Jetsama/DigitalLogicProject/README.md

The Digital Logic Tool is used to help students visualize and use digital logic gates. Each logic gate becomes a physical object for the student to interconnect an experiement with.
