Jetsama/DigitalLogicProject/DOCS/HonorsPoster.odp

Association or meeting title

Date

Department of Electrical and Computer Engineering

Jonathan Hess

Digital Logic Lab Tool

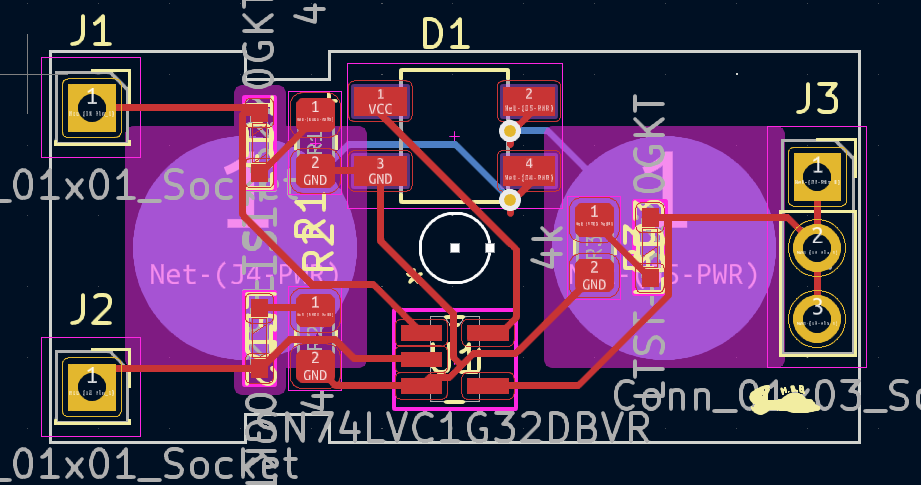
[picture p1: figure]

Content

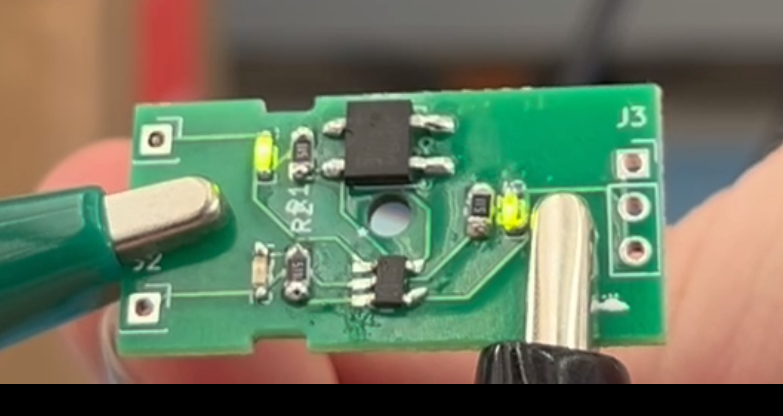
[picture p2: figure]
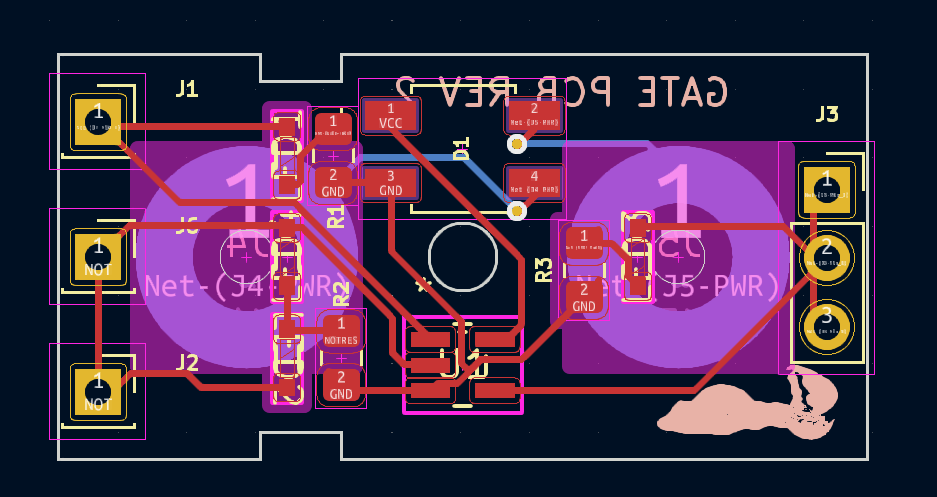
[picture p3: figure]

Acknowledgments
