Jetsama/DigitalLogicProject/PCBS/NOT/documents/pcb.pdf

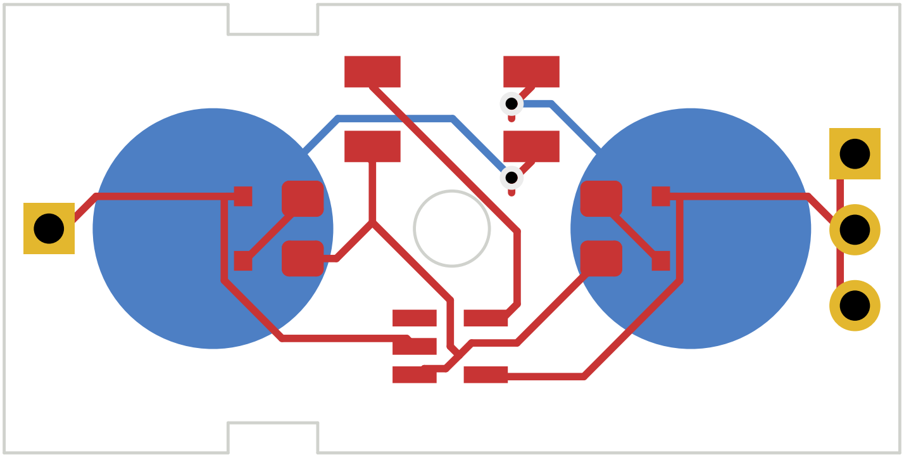
[picture p4: figure]
