Jetsama/DigitalLogicProject/Diagrams/MultiPCBBoardDesign.drawio.png

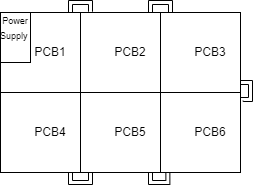
Diagrams/MultiPCBBoardDesign.drawio.png
