Jetsama/DigitalLogicProject/DOCS/images/REV1GATECase.png

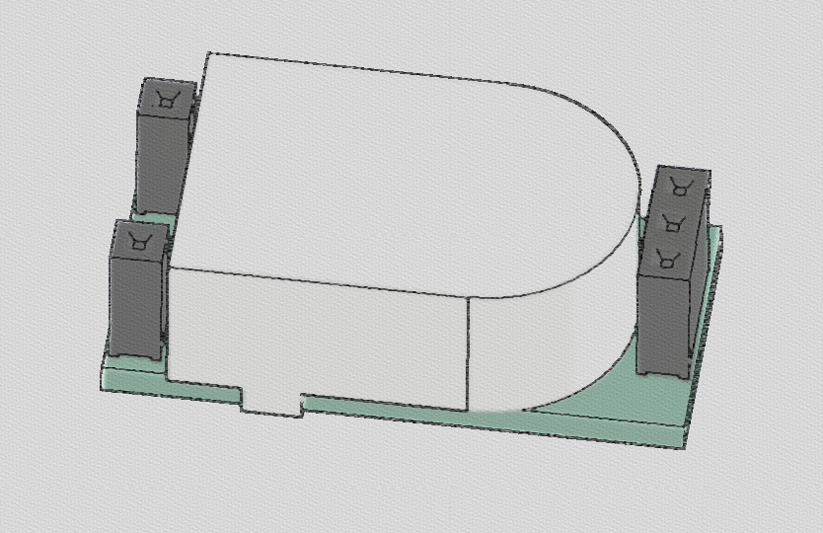
DOCS/images/REV1GATECase.png
