Jetsama/DigitalLogicProject/Models/ANDGATE/AndGate.bmp

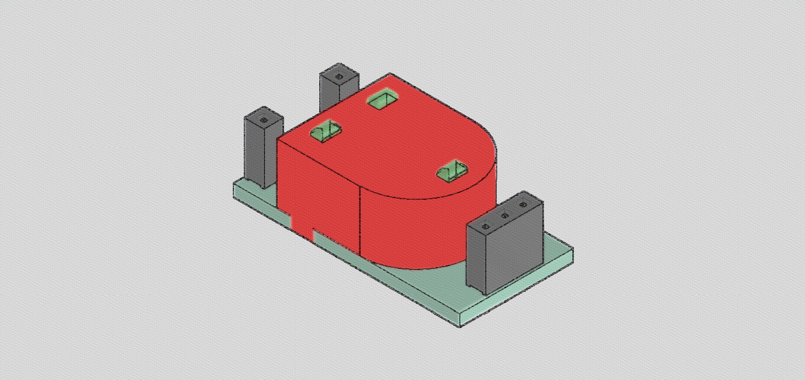
Models/ANDGATE/AndGate.bmp
