Jetsama/DigitalLogicProject/Models/MUX/MuxGate.bmp

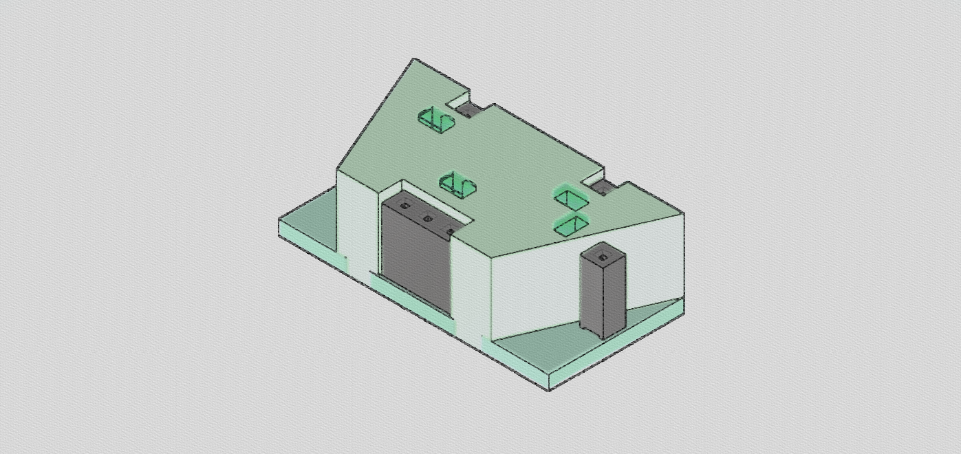
Models/MUX/MuxGate.bmp
