Jetsama/DigitalLogicProject/Models/NOTGATE/not.png

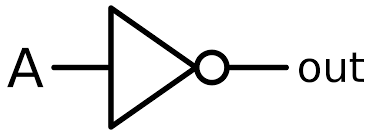
Models/NOTGATE/not.png
