Jetsama/DigitalLogicProject/Models/XORGATE/XorGate.bmp

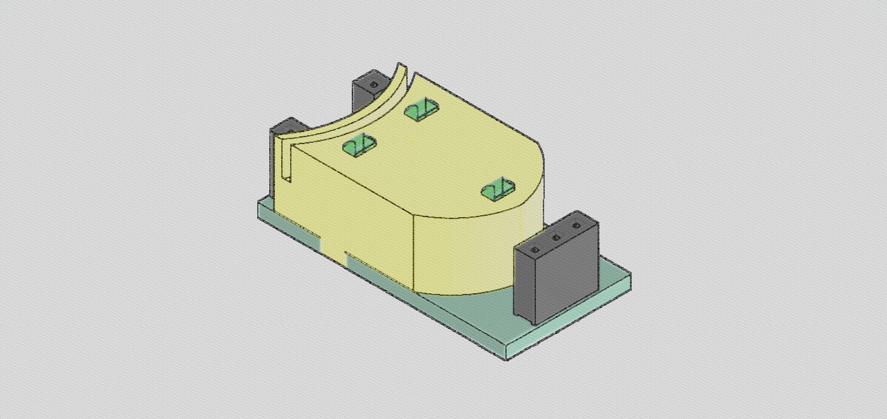
Models/XORGATE/XorGate.bmp
