Jetsama/DigitalLogicProject/DIGITALLOGICFOOTPRINTS/3D model/LTST-S220GKT.stp

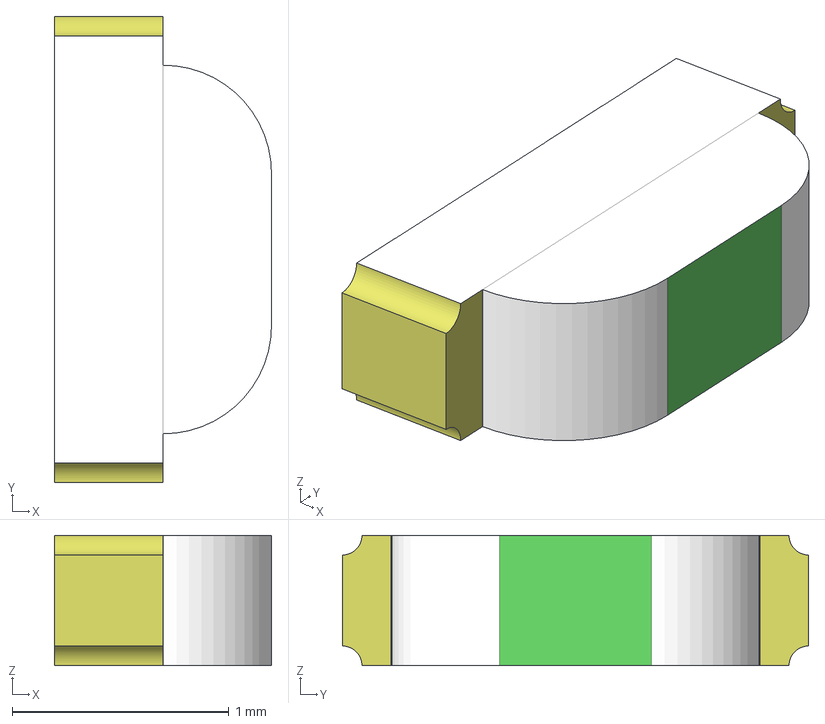
[picture p11: CAD file, 2024-03-07]
DIGITALLOGICFOOTPRINTS/3D model/LTST-S220GKT.stp
1.00 x 2.15 x 0.6 mm
