Jetsama/DigitalLogicProject/Models/ANDGATE/ANDGATE.stl

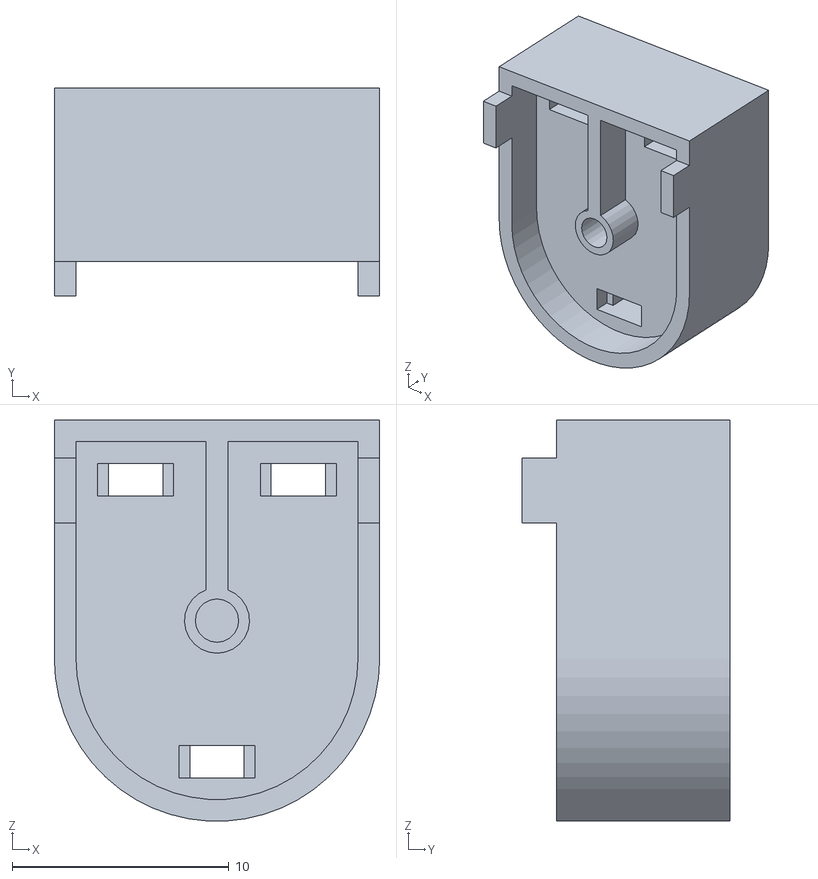
[picture p12: CAD file, 2024-03-28]
Models/ANDGATE/ANDGATE.stl
15.0 x 9.60 x 18.5
