Jetsama/DigitalLogicProject/Models/LIGHTPIPING/LightPipeThin.stl

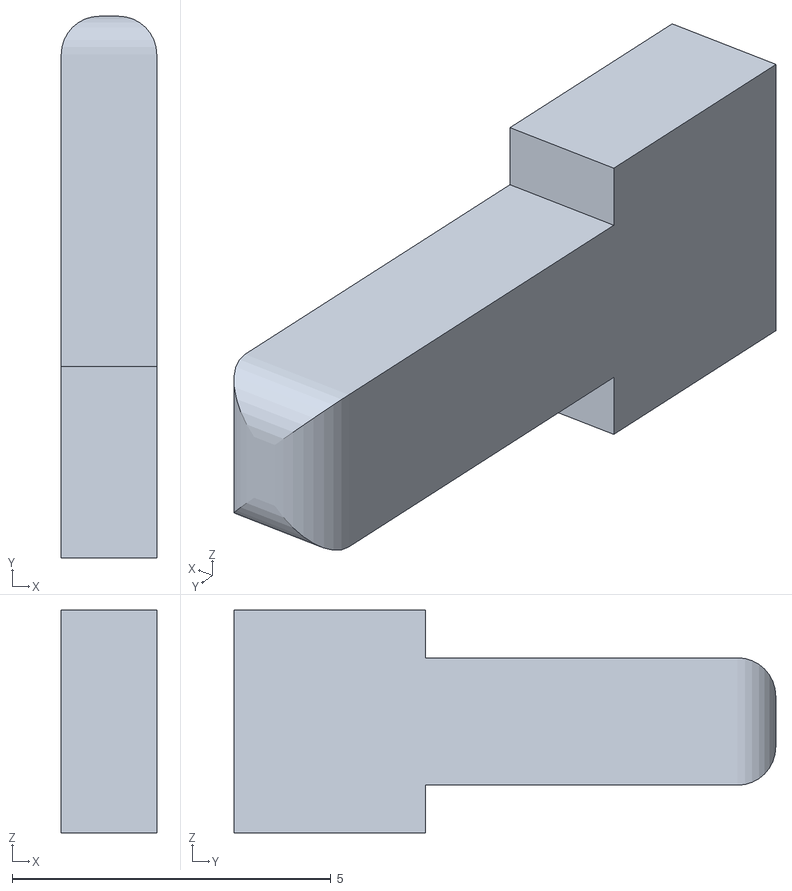
[picture p13: CAD file, 2024-03-28]
Models/LIGHTPIPING/LightPipeThin.stl
1.50 x 8.50 x 3.50
