Jetsama/DigitalLogicProject/Models/MUX/MUX.stl

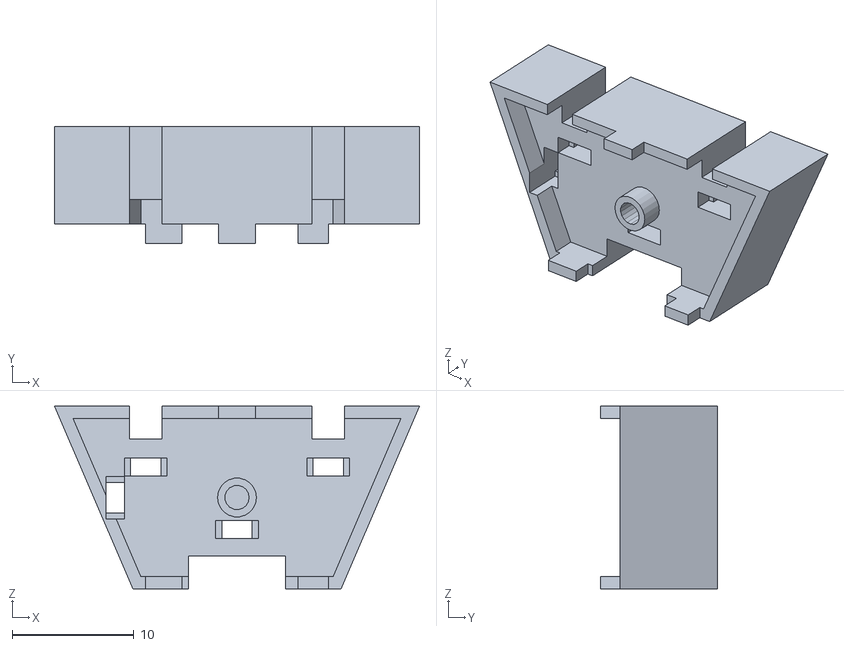
[picture p14: CAD file, 2024-04-11]
Models/MUX/MUX.stl
30.0 x 9.60 x 15.0
