Jetsama/DigitalLogicProject/Models/NANDGATE/NANDGATE.stl

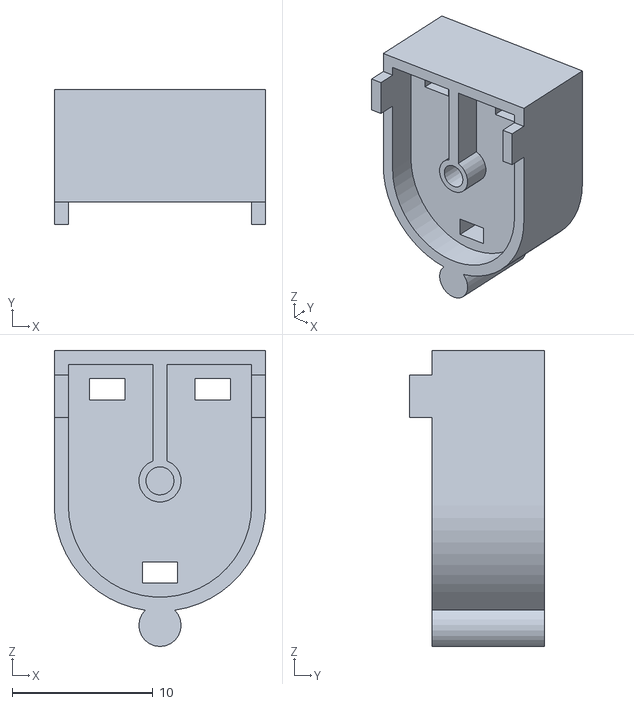
[picture p15: CAD file, 2024-03-28]
Models/NANDGATE/NANDGATE.stl
15.0 x 9.60 x 21.0
