Jetsama/DigitalLogicProject/Models/NORGATE/NORGATE.stl

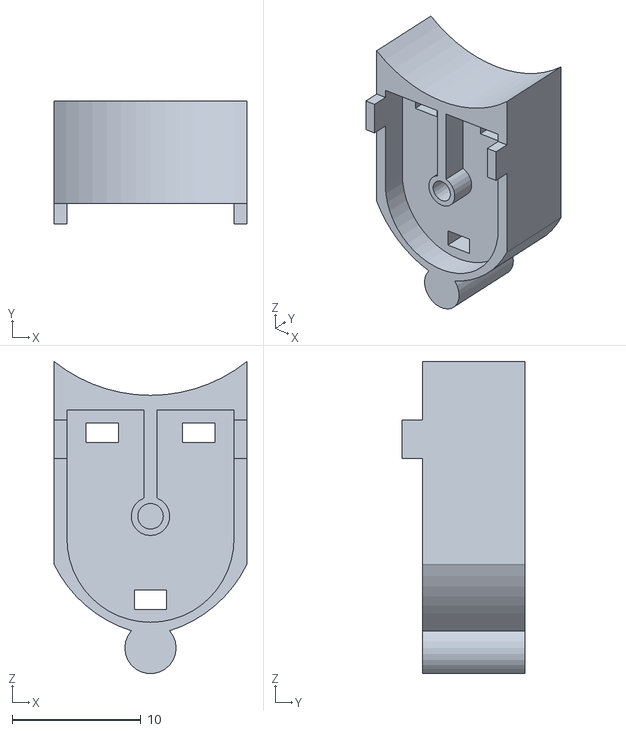
[picture p16: CAD file, 2024-03-28]
Models/NORGATE/NORGATE.stl
15.0 x 9.60 x 24.3
