Jetsama/DigitalLogicProject/Models/NOTGATE/NOTGATE.stl

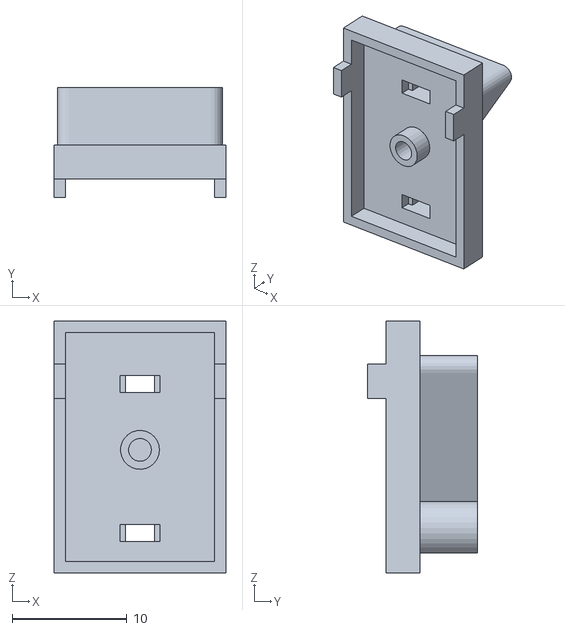
[picture p17: CAD file, 2024-03-28]
Models/NOTGATE/NOTGATE.stl
15.0 x 9.60 x 22.0
