Jetsama/DigitalLogicProject/Models/XORGATE/XORGATE.stl

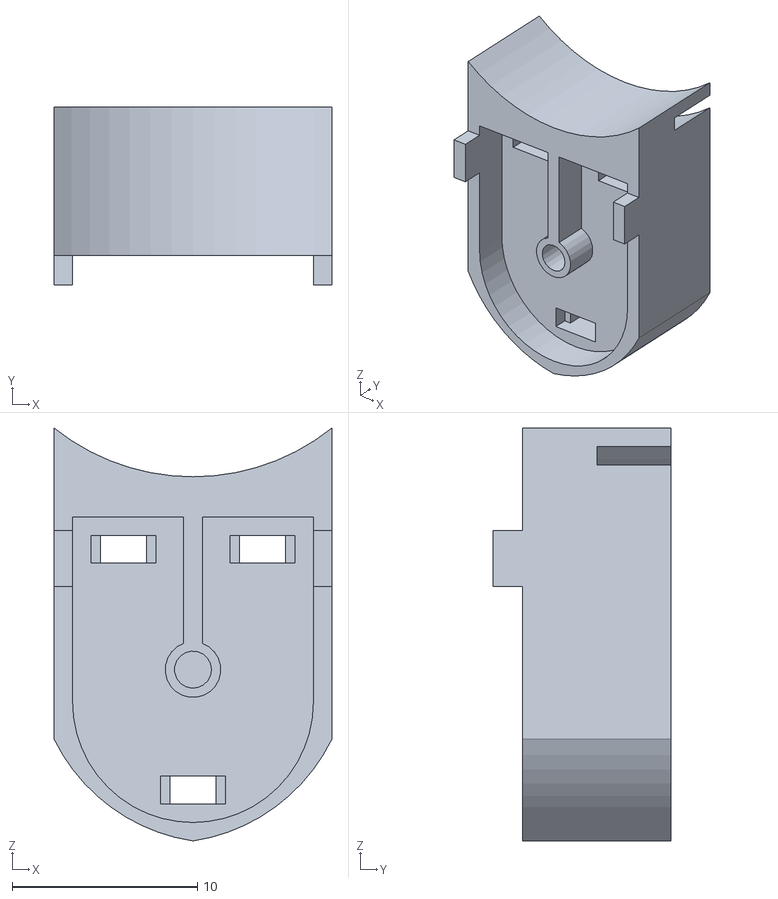
[picture p18: CAD file, 2024-03-28]
Models/XORGATE/XORGATE.stl
15.0 x 9.60 x 22.3
