Jetsama/DigitalLogicProject/PCBS/DISPLAY/DISPLAY.step

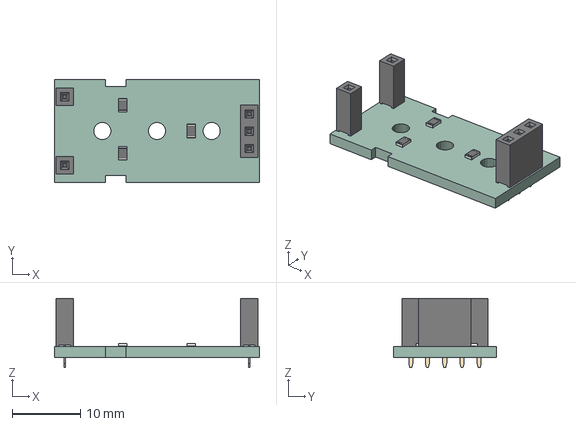
[picture p19: CAD file, 2024-03-07]
PCBS/DISPLAY/DISPLAY.step
30.0 x 15.0 x 10.1 mm
GATE PCB
