Jetsama/DigitalLogicProject/PCBS/MUX/MUX.step

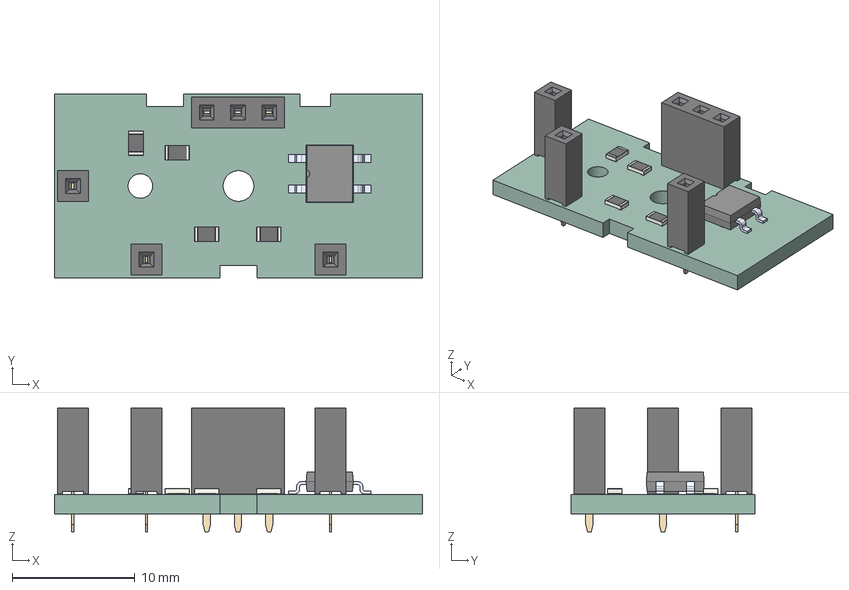
[picture p20: CAD file, 2024-03-15]
PCBS/MUX/MUX.step
30.0 x 15.0 x 10.1 mm
_autosave-MUX PCB
