Jetsama/DigitalLogicProject/PCBS/SWITCHES/SWITCHES.step

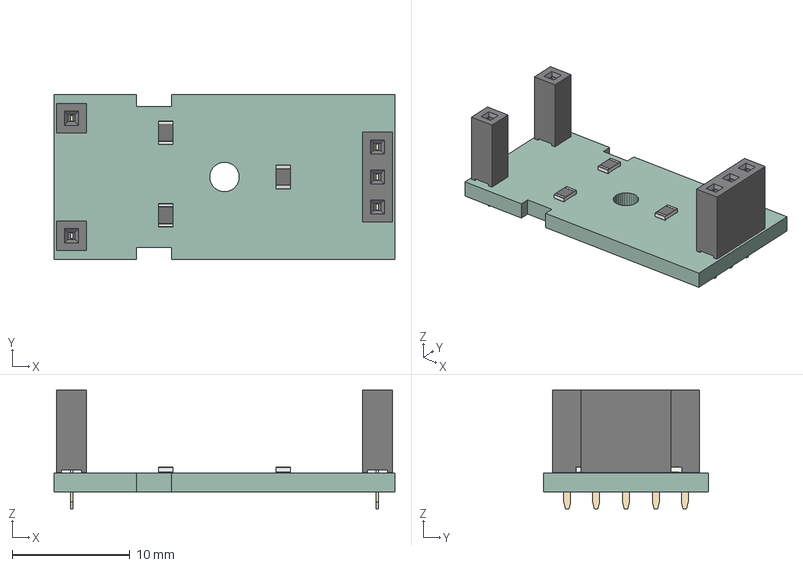
[picture p21: CAD file, 2024-01-23]
PCBS/SWITCHES/SWITCHES.step
29.0 x 14.0 x 10.1 mm
ANDGATE PCB
