Jetsama/DigitalLogicProject/DIGITALLOGICFOOTPRINTS/3D model/IRLZ44NPBF.step

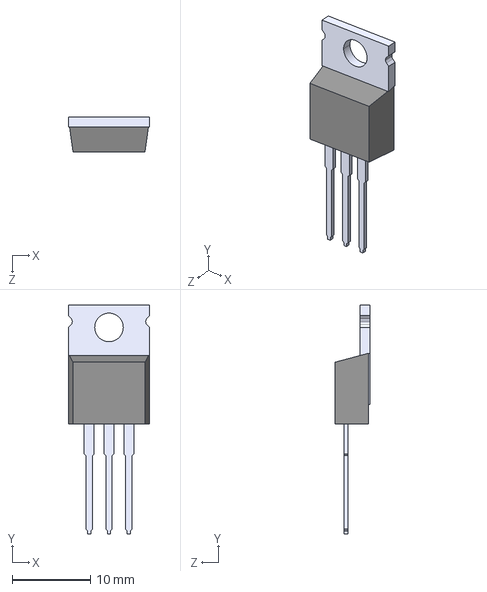
[picture p22: CAD file, 2024-03-07]
DIGITALLOGICFOOTPRINTS/3D model/IRLZ44NPBF.step
10.4 x 29.3 x 4.45 mm
