Jetsama/DigitalLogicProject/Models/LIGHTPIPING/LightPipe.stl

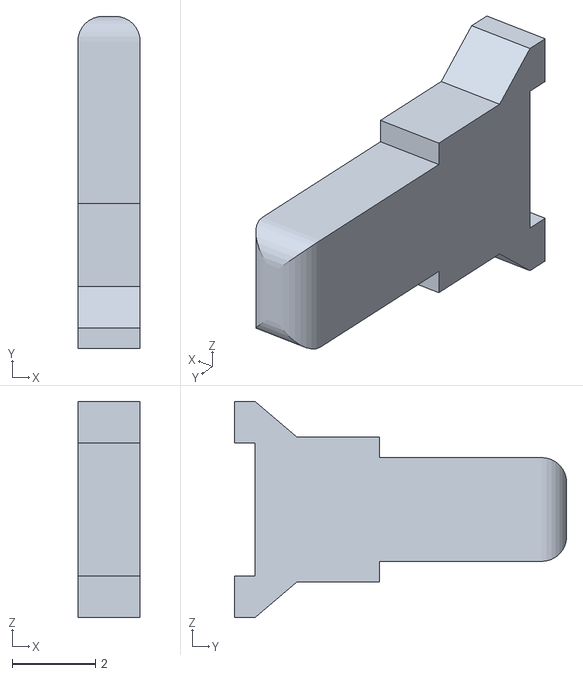
[picture p23: CAD file, 2024-03-28]
Models/LIGHTPIPING/LightPipe.stl
1.50 x 8.00 x 5.20
