Jetsama/DigitalLogicProject/PCBS/DISPLAY/ANDGATE.step

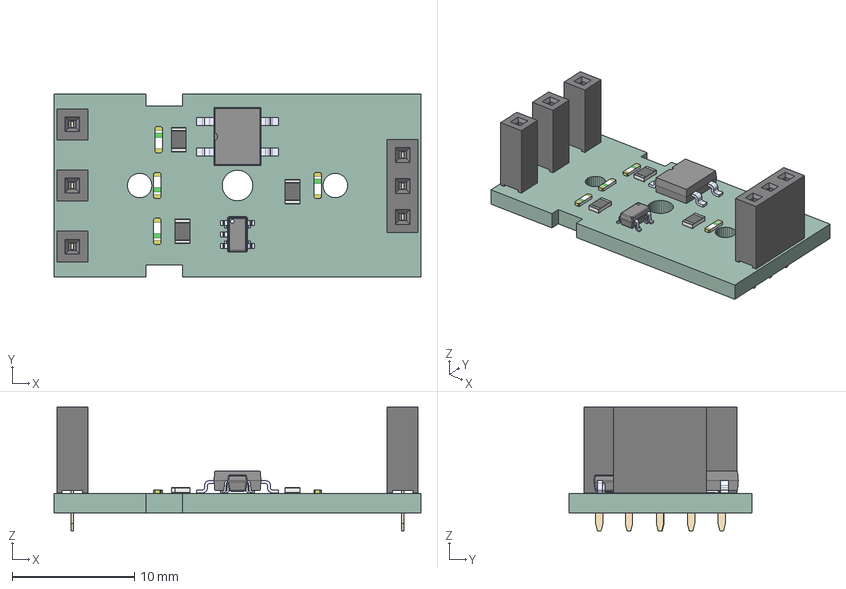
[picture p24: CAD file, 2024-03-07]
PCBS/DISPLAY/ANDGATE.step
30.0 x 15.0 x 10.1 mm
GATE PCB
