Jetsama/DigitalLogicProject/DIGITALLOGICFOOTPRINTS/3D model/MB10F-13.step

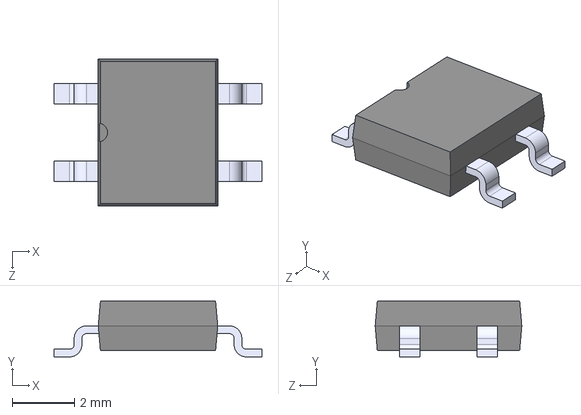
[picture p25: CAD file, 2024-02-16]
DIGITALLOGICFOOTPRINTS/3D model/MB10F-13.step
6.70 x 1.80 x 4.72 mm
