Jetsama/DigitalLogicProject/Models/LIGHTPIPING/LightPipe1mm.stl

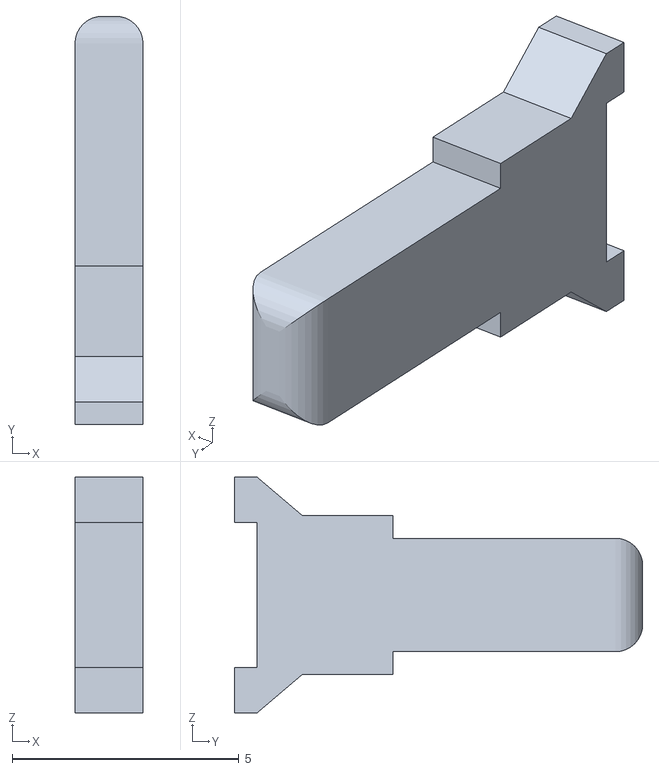
[picture p26: CAD file, 2024-03-28]
Models/LIGHTPIPING/LightPipe1mm.stl
1.50 x 9.00 x 5.20
