Jetsama/DigitalLogicProject/Models/LIGHTPIPING/LightPipeThin1m.stl

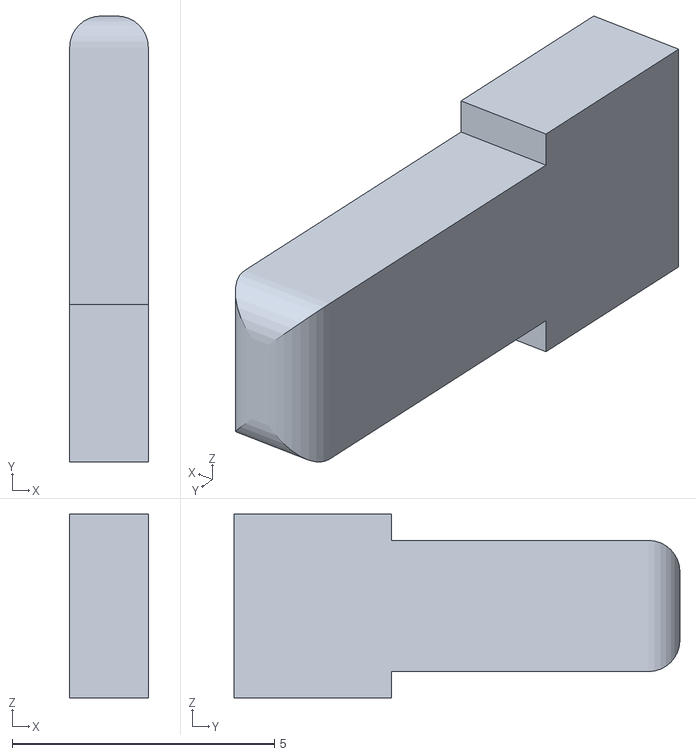
[picture p27: CAD file, 2024-03-28]
Models/LIGHTPIPING/LightPipeThin1m.stl
1.50 x 8.50 x 3.50
