Jetsama/DigitalLogicProject/DIGITALLOGICFOOTPRINTS/3D model/CUI_DEVICES_RDS-16S-1045-D.step

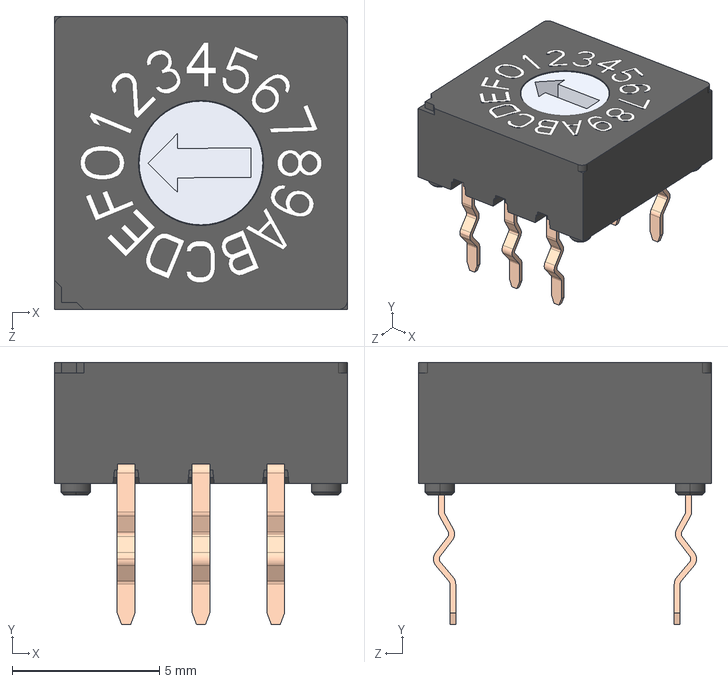
[picture p28: CAD file, 2024-02-16]
DIGITALLOGICFOOTPRINTS/3D model/CUI_DEVICES_RDS-16S-1045-D.step
9.95 x 8.91 x 9.95 mm
