Jetsama/DigitalLogicProject/DIGITALLOGICFOOTPRINTS/3D model/CUI_DEVICES_RDS-16S-1055-SMT.step

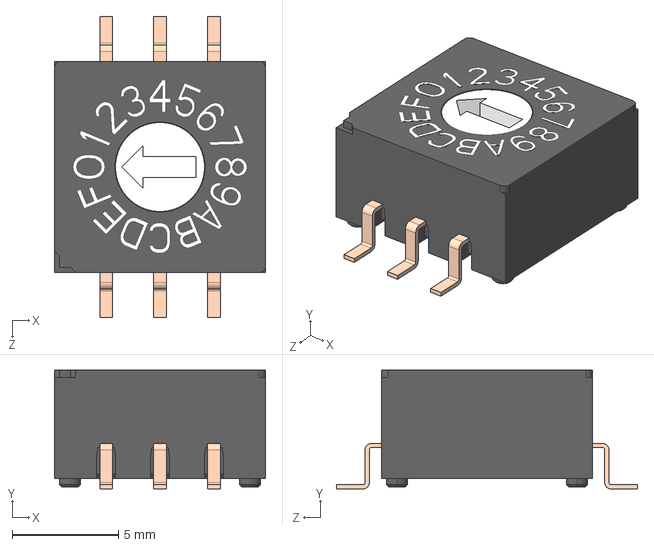
[picture p29: CAD file, 2024-02-16]
DIGITALLOGICFOOTPRINTS/3D model/CUI_DEVICES_RDS-16S-1055-SMT.step
9.95 x 5.61 x 14.2 mm
