Jetsama/DigitalLogicProject/DIGITALLOGICFOOTPRINTS/3D model/SN74LVC1GU04.step

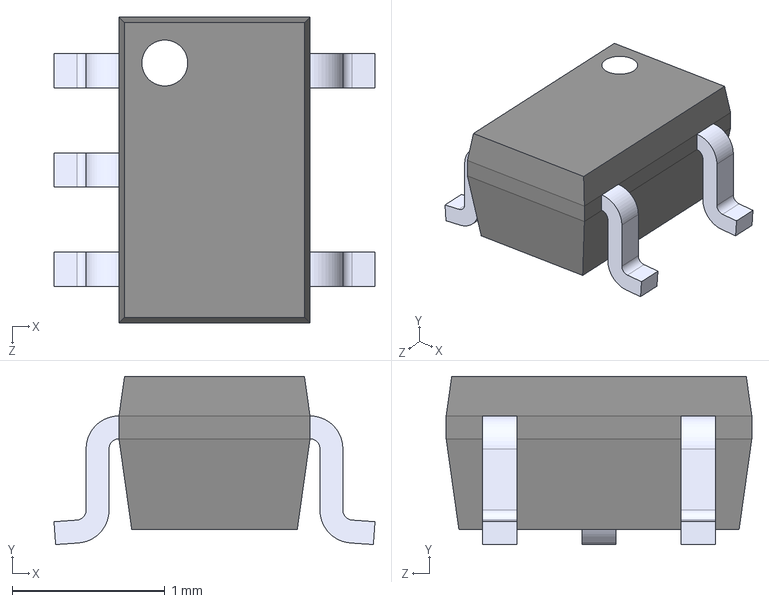
[picture p30: CAD file, 2024-02-16]
DIGITALLOGICFOOTPRINTS/3D model/SN74LVC1GU04.step
2.10 x 1.10 x 2.00 mm
