Jetsama/DigitalLogicProject/DIGITALLOGICFOOTPRINTS/3D model/SN74LVC2G157DCTR.step

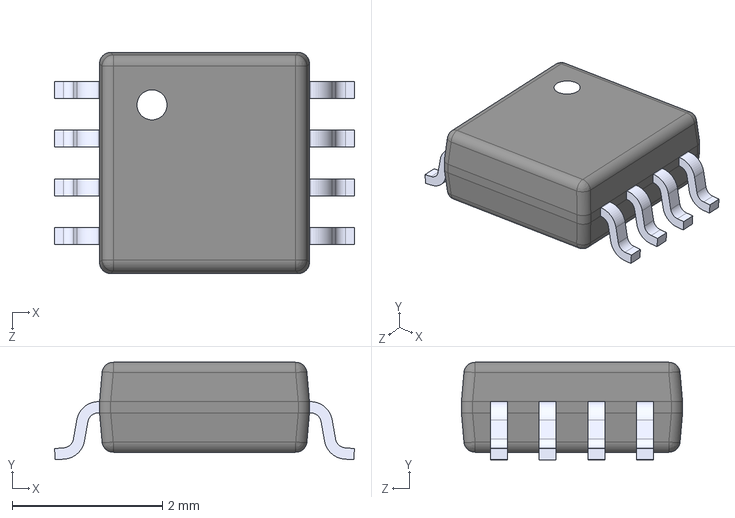
[picture p31: CAD file, 2024-02-16]
DIGITALLOGICFOOTPRINTS/3D model/SN74LVC2G157DCTR.step
4.00 x 1.30 x 2.95 mm
