Jetsama/DigitalLogicProject/DIGITALLOGICFOOTPRINTS/3D model/CD4043BPWR.step

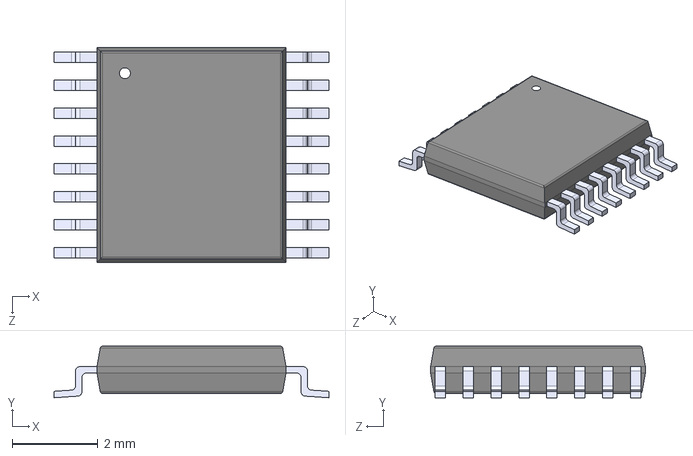
[picture p32: CAD file, 2024-02-16]
DIGITALLOGICFOOTPRINTS/3D model/CD4043BPWR.step
6.40 x 1.20 x 5.00 mm
