Jetsama/DigitalLogicProject/DIGITALLOGICFOOTPRINTS/3D model/SN74LVC1G08DBVRE4.step

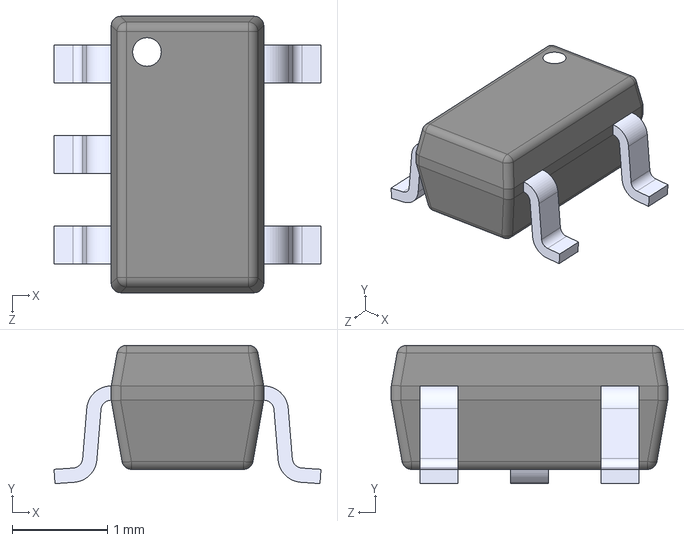
[picture p33: CAD file, 2024-02-16]
DIGITALLOGICFOOTPRINTS/3D model/SN74LVC1G08DBVRE4.step
2.80 x 1.45 x 2.90 mm
