Jetsama/DigitalLogicProject/(list of files, cad)

Other CAD files:
Models/ORGATE/ORGATE.stl
DIGITALLOGICFOOTPRINTS/3D model/1571527-2.step
Gates/NOTGATE/ANDGATE PCB.ipt
Gates/NOTGATE/OldVersions/ANDGATE PCB.0003.ipt
Models/ANDGATE/ANDGATE PCB.ipt
Models/ANDGATE/ANDGATE.iam
Models/ANDGATE/ANDGATE.ipt
Models/ANDGATE/ANDGATEASSEMBLY.iam
Models/ANDGATE/OldVersions/ANDGATE.0015.ipt
Models/ANDGATE/OldVersions/ANDGATEASSEMBLY.0003.iam
Models/LIGHTPIPING/LightPipe.ipt
Models/LIGHTPIPING/LightPipeThin.ipt
Models/LIGHTPIPING/OldVersions/LightPipe.0003.ipt
Models/LIGHTPIPING/OldVersions/LightPipeThin.0001.ipt
Models/MUX/MUX.ipt
Models/MUX/MUXAssembly1.iam
Models/MUX/MUXPCB.ipt
Models/MUX/OldVersions/MUX.0010.ipt
Models/MUX/OldVersions/MUXAssembly1.0001.iam
Models/MUX/OldVersions/MUXPCB.0001.ipt
Models/NANDGATE/NANDGATE.ipt
Models/NANDGATE/NANDGATEASSEMBLY.iam
Models/NANDGATE/OldVersions/NANDGATE.0004.ipt
Models/NANDGATE/OldVersions/NANDGATEASSEMBLY.0003.iam
Models/NORGATE/NORGATE.ipt
Models/NORGATE/NORGATEASSEMBLY.iam
Models/NORGATE/OldVersions/NORGATE.0005.ipt
Models/NORGATE/OldVersions/NORGATEASSEMBLY.0002.iam
Models/NOTGATE/NOTGATE.ipt
Models/NOTGATE/NOTGATE2.ipt
Models/NOTGATE/NOTGATEASSEMBLY.iam
Models/NOTGATE/OldVersions/NOTGATE.0005.ipt
Models/NOTGATE/OldVersions/NOTGATE2.0003.ipt
Models/NOTGATE/OldVersions/NOTGATEASSEMBLY.0001.iam
Models/ORGATE/ORGATE.ipt
Models/ORGATE/ORGATEASSEMBLY.iam
Models/ORGATE/OldVersions/ORGATE.0006.ipt
Models/ORGATE/OldVersions/ORGATEASSEMBLY.0002.iam
Models/XORGATE/OldVersions/XORGATE.0002.ipt
Models/XORGATE/OldVersions/XORGATEASSEMBLY.0002.iam
Models/XORGATE/XORGATE.ipt
Models/XORGATE/XORGATEASSEMBLY.iam
PCBS/DISPLAY/ANDGATEASSEMBLY.iam
PCBS/DISPLAY/DISPLAY.iam
PCBS/DISPLAY/DISPLAY.ipt
PCBS/DISPLAY/GATE PCB.ipt
PCBS/DISPLAY/OldVersions/ANDGATE PCB.0001.ipt
PCBS/DISPLAY/OldVersions/ANDGATE.0008.ipt
PCBS/DISPLAY/OldVersions/GATE PCB.0002.ipt
PCBS/DISPLAY/PinSocket_1x01_P2.54mm_Vertical.iam
PCBS/DISPLAY/PinSocket_1x03_P2.54mm_Vertical.iam
PCBS/DISPLAY/Quarter.ipt
PCBS/DISPLAY/R_0805_2012Metric.iam
PCBS/DISPLAY/SOLID.ipt
PCBS/DISPLAY/SOLID_1.ipt
PCBS/DISPLAY/SOLID_2.ipt
PCBS/GATE/GATE PCB.ipt
PCBS/GATE/OldVersions/GATE PCB.0004.ipt
