Jetsama/DigitalLogicProject/(threads)

Thread 1 (2023-12-20):

Creation of AND gate PCB

Jetsama, 2023-12-20:
Create an AND gate PCB with two 8mm button inputs at the bottom and 3 input 5mm on the top.

Jetsama, 2023-12-29:
Completed with the PCB shown below. Changed to using standard socket pin headers rather than 5mm.

PCB Design:
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

3D Model:
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

Finalization of PCB will add ridges to allow casing to grip onto PCB and also potentially needing to move D1 for screw tolerances.

Closed 2023-12-29.

Thread 2 (2023-12-29):

Creation of AND gate casing

Jetsama, 2023-12-29:
Create 3D model for AND gate PCB with screw hole and holes for header pins.
This case should look similar to how a AND gate looks in diagrams. An example of an old casing model is shown below.
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

Jetsama, 2024-01-23:
Added mounting grooves. Last step is to add holes for light piping the leds.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

Jetsama, 2024-03-14:
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
Added the LED piping

Closed 2024-03-14.

Thread 3 (2023-12-29):

Create paneling for JLCPCB

Jetsama, 2023-12-29:
Create a paneling design to allow for 10 PCB's per board (with 5 maximum different designs).
This information is laid out in the [PCB-Panelization](https://jlcpcb.com/help/article/96-PCB-Panelization) page on JLCPCB.

The current plan for designs are:

1. 2 input, 1 output GATE (AND,OR,NAND, etc)
2. 1 input, 1 output GATE (NOT)
3. inputs PCB (for switches and buttons)
4. Mux GATE
5. 7 segment display PCB

Jetsama, 2024-02-16:
Paneling has 15 dollar fee for designs with size less than 1.5cm by 1.5cm.
This actually should be worded that if any dimension is less than 1.5cm it will be feed. This means that the size of the PCB cannot be 1.4cm by 2.9cm.
https://jlcpcb.com/help/article/55-How-do-I-order-a-panel
We need to increase size of PCB to height of 1.5cm if we want to use panel.

Jetsama, 2024-02-17:
Calculated costs and used panelization by JLCPCB. for
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

Without Engineering Fees (4 dollars): (Col: PCB per panel, Row: Panels)
|     | 15      |     |        | 18      |     |        | 21      |     |        | 24      |     |        | 27      |     |        | 30      |     |        |
| :-- | :------ | :-- | :----- | :------ | :-- | :----- | :------ | :-- | :----- | :------ | :-- | :----- | :------ | :-- | :----- | :------ | :-- | :----- |
| 5   | $3.80  | 75  | $0.05 | $4.30  | 90  | $0.05 | $4.90  | 105 | $0.05 | $5.40  | 120 | $0.05 | $6.00  | 135 | $0.04 | $6.50  | 150 | $0.04 |
| 10  | $6.50  | 150 | $0.04 | $7.60  | 180 | $0.04 | $8.70  | 210 | $0.04 | $9.70  | 240 | $0.04 | $10.80 | 270 | $0.04 | $11.90 | 300 | $0.04 |
| 15  | $9.20  | 225 | $0.04 | $10.80 | 270 | $0.04 | $12.50 | 315 | $0.04 | $14.00 | 360 | $0.04 | $15.70 | 405 | $0.04 | $17.30 | 450 | $0.04 |
| 20  | $11.90 | 300 | $0.04 | $14.00 | 360 | $0.04 | $16.30 | 420 | $0.04 | $18.40 | 480 | $0.04 | $20.50 | 540 | $0.04 | $22.70 | 600 | $0.04 |

The cost of board goes down to 4 cents regardless of number. This means that no reason for mid-mass quantity doesn't yield benefit over 135 boards from JLCPCB.

Closed 2024-02-17.

Thread 4 (2023-12-29):

Creation of NOT gate PCB

Jetsama, 2023-12-29:
Create a NOT gate PCB with two 8mm button inputs at the bottom following grid design. Also includes the input 1 pin header and output 3 pin socket header.

Jetsama, 2024-01-29:
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
Finished NOT gate PCB

Closed 2024-01-29.

Thread 5 (2024-01-17):

Creation of MUX gate PCB

Jetsama, 2024-01-17:
Create a MUX gate PCB with two 8mm button inputs at the bottom following grid design. Also includes the 3 input pin headers one on top and 2 pin headers on side. Then we have theoutput 3 pin socket header.

Should be laid out like so:
```c

      1
   _______
1 |       \
  |        \
  |         | 3
  |        /
1 |_______/
```

Jetsama, 2024-02-12:
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

Created Mux PCB with 3 inputs and 1 output.
Cleanup of Silkscreen still preferred before production.
BOM and JLCPCB output needed.

Closed 2024-02-12.

Thread 6 (2024-01-24):

Creation of NOT gate casing

Jetsama, 2024-01-24:
Create 3D model for NOT gate PCB with screw hole and holes for header pins.
This case should look similar to the NOT gate symbol that is used in diagrams.
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

Jetsama, 2024-03-15:
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

Closed 2024-03-15.

Thread 7 (2024-01-24):

Creation of OR gate casing

Jetsama, 2024-01-24:
Create 3D model for OR gate PCB with screw hole and holes for header pins.
This case should look similar to the OR gate symbol that is used in diagrams.
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

Jetsama, 2024-03-15:
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

Closed 2024-03-15.

Thread 8 (2024-01-24):

Creation of MUX gate casing

Jetsama, 2024-01-24:
Create 3D model for multiplexer gate PCB with screw hole and holes for header pins.
This case should look similar to the multiplexer gate symbol that is used in diagrams.
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

Jetsama, 2024-03-15:
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

Closed 2024-03-15.

Thread 10 (2024-02-12):

Creation of 3D casing for power board

Jetsama, 2024-02-12:
Create a 3D casing for the power board that holds the sheets together and protects against cuts on the metal layers.
Should also have space for the barrel connector and other parts on the board PCB.

Thread 11 (2024-02-12):

Creation of Power Board PCB

Jetsama, 2024-02-12:
Create a PCB for the power board that allows for the following functions and features:

- Fault or overdraw detection i.e circuit breaker (if too much current is drawn then it breaks connection to board)
- Fault LED (shows the user if the board is in a fault state)
- Power indicator light (shows the user if power is present)
- ON/OFF Switch
- 5V Barrel Connector for power
- Fault reset button (for resetting fault state / not required as power cycling should reset state)

Jetsama, 2024-03-14:
Switched from Barrel Connector to USB.
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
Also allow for INPUTS/OUTPUTS to test circuits.

Inputs include rotary switch, 2 buttons (1 for fault), and 8 pins on board.

Each of the boards can connect to 4 others if expansion is needed.

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

Thread 12 (2024-02-12):

Creation of NAND gate casing

Jetsama, 2024-02-12:
Create 3D model for NAND gate PCB with screw hole and holes for LEDS.
This case should look similar to the NAND gate symbol that is used in diagrams.
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

Jetsama, 2024-03-15:
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

Closed 2024-03-15.

Thread 13 (2024-02-12):

Creation of NOR gate casing

Jetsama, 2024-02-12:
Create 3D model for NOR gate PCB with screw hole and holes for LEDS.
This case should look similar to the NOR gate symbol that is used in diagrams.
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

Jetsama, 2024-03-15:
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

Closed 2024-03-15.

Thread 9 (2024-02-12):

Creation of Inputs PCB

Jetsama, 2024-02-12:
Create a schematic and PCB that is interchangeable use for the following inputs:

- Rocker Switches
- [16 pin Rotary Switch](https://www.mouser.com/c/electromechanical/switches/coded-rotary-switches/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)
- Push buttons

This PCB will need to have debouncing for the buttons and switches and need to have screw hole and fins for fitting the casings.

Jetsama, 2024-02-14:
Created design that allows for rotary and rocker switch (via 3 pin header). Push button support still needed (Adding the footprint to top level)

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

Rocker Switch/Button Setup:
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

Rotary Switch Setup:
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

Jetsama, 2024-02-17:
Added 6mm SMD button. Potential issues when using rotary switch where output 2 (3rd one down) could short to output 1 (2nd one down).
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

Solution will be to move 3 pin output from
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
to
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
This also removed issues with multiple LED locations and using SMD header for output 2 (3rd one down).

Closed 2024-02-17.

Thread 14 (2024-02-13):

Creation of Ouputs PCB

Jetsama, 2024-02-13:
Create PCB for the outputs. Currently the only planned output is a 7 segment display. The module should take in two 4 bit values to create 2 hex numbers on the display.

There is a problem in implementing this that existing binary to hex display driver chips are not produced anymore. Instead we will be using an atmega8 for taking in inputs and producing outputs (via a lookup table). We can dedicate a port to taking the 4 inputs and then 2 ports to producing the outputs.

Another output we can create is using the MCU to create pseudo inputs and check the outputs of the circuit for puzzles.

The obsolete part is the [MC14495P1 ](https://www.futurlec.com/Motorola/MC14495P1.shtml)
Current parts only convert to decimal such as this [BCD Seven Segment Decoder](https://www.ti.com/lit/ds/symlink/sn5447a.pdf?ts=1707822763977&ref_url=https%253A%252F%252Fwww.google.com%252F)

Closed 2024-03-14.

Thread 15 (2024-02-17):

Combine NOT GATE PCB with GATE PCB

Jetsama, 2024-02-17:
These should not have been different PCBs. The header pin and Led location should have been the only change.

Jetsama, 2024-03-14:
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
Added 3rd pin option and another optional led for NOT gate.

Closed 2024-03-14.

Thread 16 (2024-02-17):

Create scripts for PCB part swapping

Jetsama, 2024-02-17:
Create or locate script that can swap part footprints in KiCAD PCBs. This can be helpful for schools to use different parts without editing each PCB.

Thread 17 (2024-03-15):

Creation of XOR gate casing

Jetsama, 2024-03-15:
Create 3D model for gate PCB with screw hole and holes for header pins.

 This case should look similar to the XOR gate symbol that is used in diagrams.

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

Jetsama, 2024-03-15:
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

Closed 2024-03-15.

Thread 18 (2024-03-18):

Resize all button holes on PCBs

Jetsama, 2024-03-18:
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

Holes are slightly too small but most likely usable

Jetsama, 2024-03-18:
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

Jetsama, 2024-04-11:
Used 5mm snaps instead (better for spacing)

Closed 2024-04-11.

Thread 20 (2024-05-01):

Floating inputs and pins

Jetsama, 2024-05-01:
Fix the floating pins by adding pull down resistors for the following inputs:

- [ ] Board Rotary Switch
- [ ] Inputs PCB (rotary switch)
- [ ] Outputs (4 bit inputs)

Jetsama, 2024-12-04:
The datasheet describes that the input pins should not be allowed to float.

[datasheet](https://www.ti.com/lit/ds/symlink/sn74lvc1g08.pdf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)

11.1 Layout Guidelines
When using multiple bit logic devices inputs should not ever float. In many cases, functions or parts of functions
of digital logic devices are unused; for example, when only two inputs of a triple-input AND gate are used or only
3 of the 4 buffer gates are used. Such input pins should not be left unconnected because the undefined voltages
at the outside connections result in undefined operational states. Specified below are the rules that must be
observed under all circumstances. All unused inputs of digital logic devices must be connected to a high or low
bias to prevent them from floating. The logic level that should be applied to any particular unused input depends
on the function of the device. Generally they will be tied to Gnd or Vcc whichever make more sense or is more

It seems that the led+resistor does not pull down enough to remove all floating.
