Jetsama/DigitalLogicProject/PCBS/DISPLAY/DISPLAY.kicad_pcb

## KiCad design PCBS/DISPLAY/DISPLAY.kicad_pcb (2024-03-14)

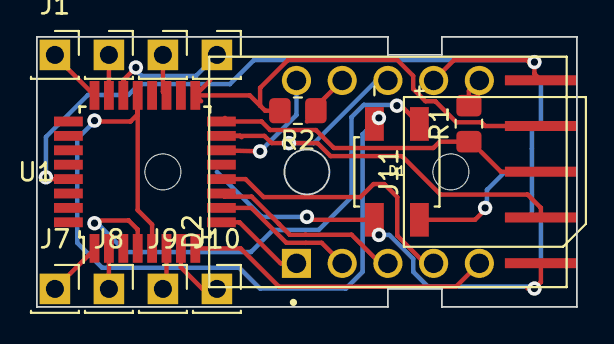
[picture p34: board DISPLAY.kicad_pcb from above]

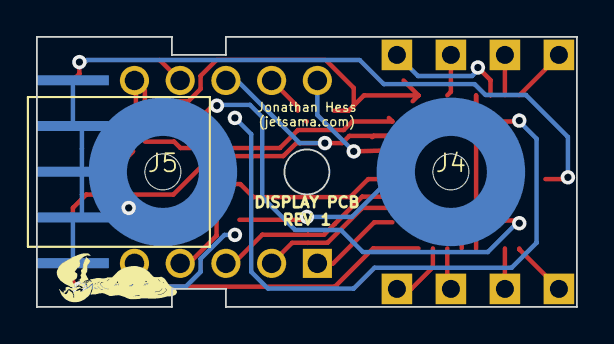
[picture p35: board DISPLAY.kicad_pcb from below]

Board: 2 copper layers, 30.0 x 15.0 mm, 16 parts (2 on the bottom side), 24 nets.

Parts:
D1: MB10F-13; DIOB_MB10F-13
D2: LTD-4708G; LED_LTD-4708G
J1, J2, J3, J6, J7, J8, J9, J10: Conn_01x01_Socket; PinSocket_1x01_P2.54mm_Vertical
J4, J5: 8mm-snap
J11: Conn_02x05_Odd_Even; Samtec_MECF-05-0_-NP-L-DV_2x05_P1.27mm_Edge
R1, R2: 300; R_0805_2012Metric_Pad1.20x1.40mm_HandSolder
U1: ATmega88PB-A; TQFP-32_7x7mm_P0.8mm

Connections:
DIGIT0: J11.5, R1.1, U1.16 (PB4)
DIGIT1: J11.7, R2.2, U1.17 (PB5)
GND: D1.3, U1.5 (GND), U1.21 (GND)
Input0: J1.1, U1.24 (PC1)
Input1: J2.1, U1.23 (PC0)
Input2: J3.1, U1.19 (PE2)
Input3: J6.1, U1.22 (PE3)
Input4: J7.1, U1.1 (PD3)
Input5: J8.1, U1.2 (PD4)
Input6: J9.1, U1.6 (PE1)
Input7: J10.1, U1.7 (XTAL1/PB6)
MOSI: D2.8, J11.3, U1.15 (PB3)
unnamed: D2.6, R1.2
unnamed: D2.9, R2.1
PW1: D1.2, J5.1 (PWR), J11.2, J11.4, J11.6, J11.8, J11.10
PW2: D1.4, J4.1 (PWR), J11.1
RST: D2.7, J11.9, U1.29 (~RESET/PC6)
SEG2: D2.3, U1.11 (PD7)
SEG3: D2.2, U1.10 (PD6)
SEG4: D2.1, U1.9 (PD5)
SEG5: D2.10, U1.14 (PB2)
SEG6: D2.4, U1.12 (PB0)
SEG7: D2.5, U1.8 (XTAL2/PB7)
VCC: D1.1, U1.4 (VCC)
