Jetsama/DigitalLogicProject/PCBS/BOARD/BOARD.kicad_pcb

## KiCad design PCBS/BOARD/BOARD.kicad_pcb (2024-03-14)

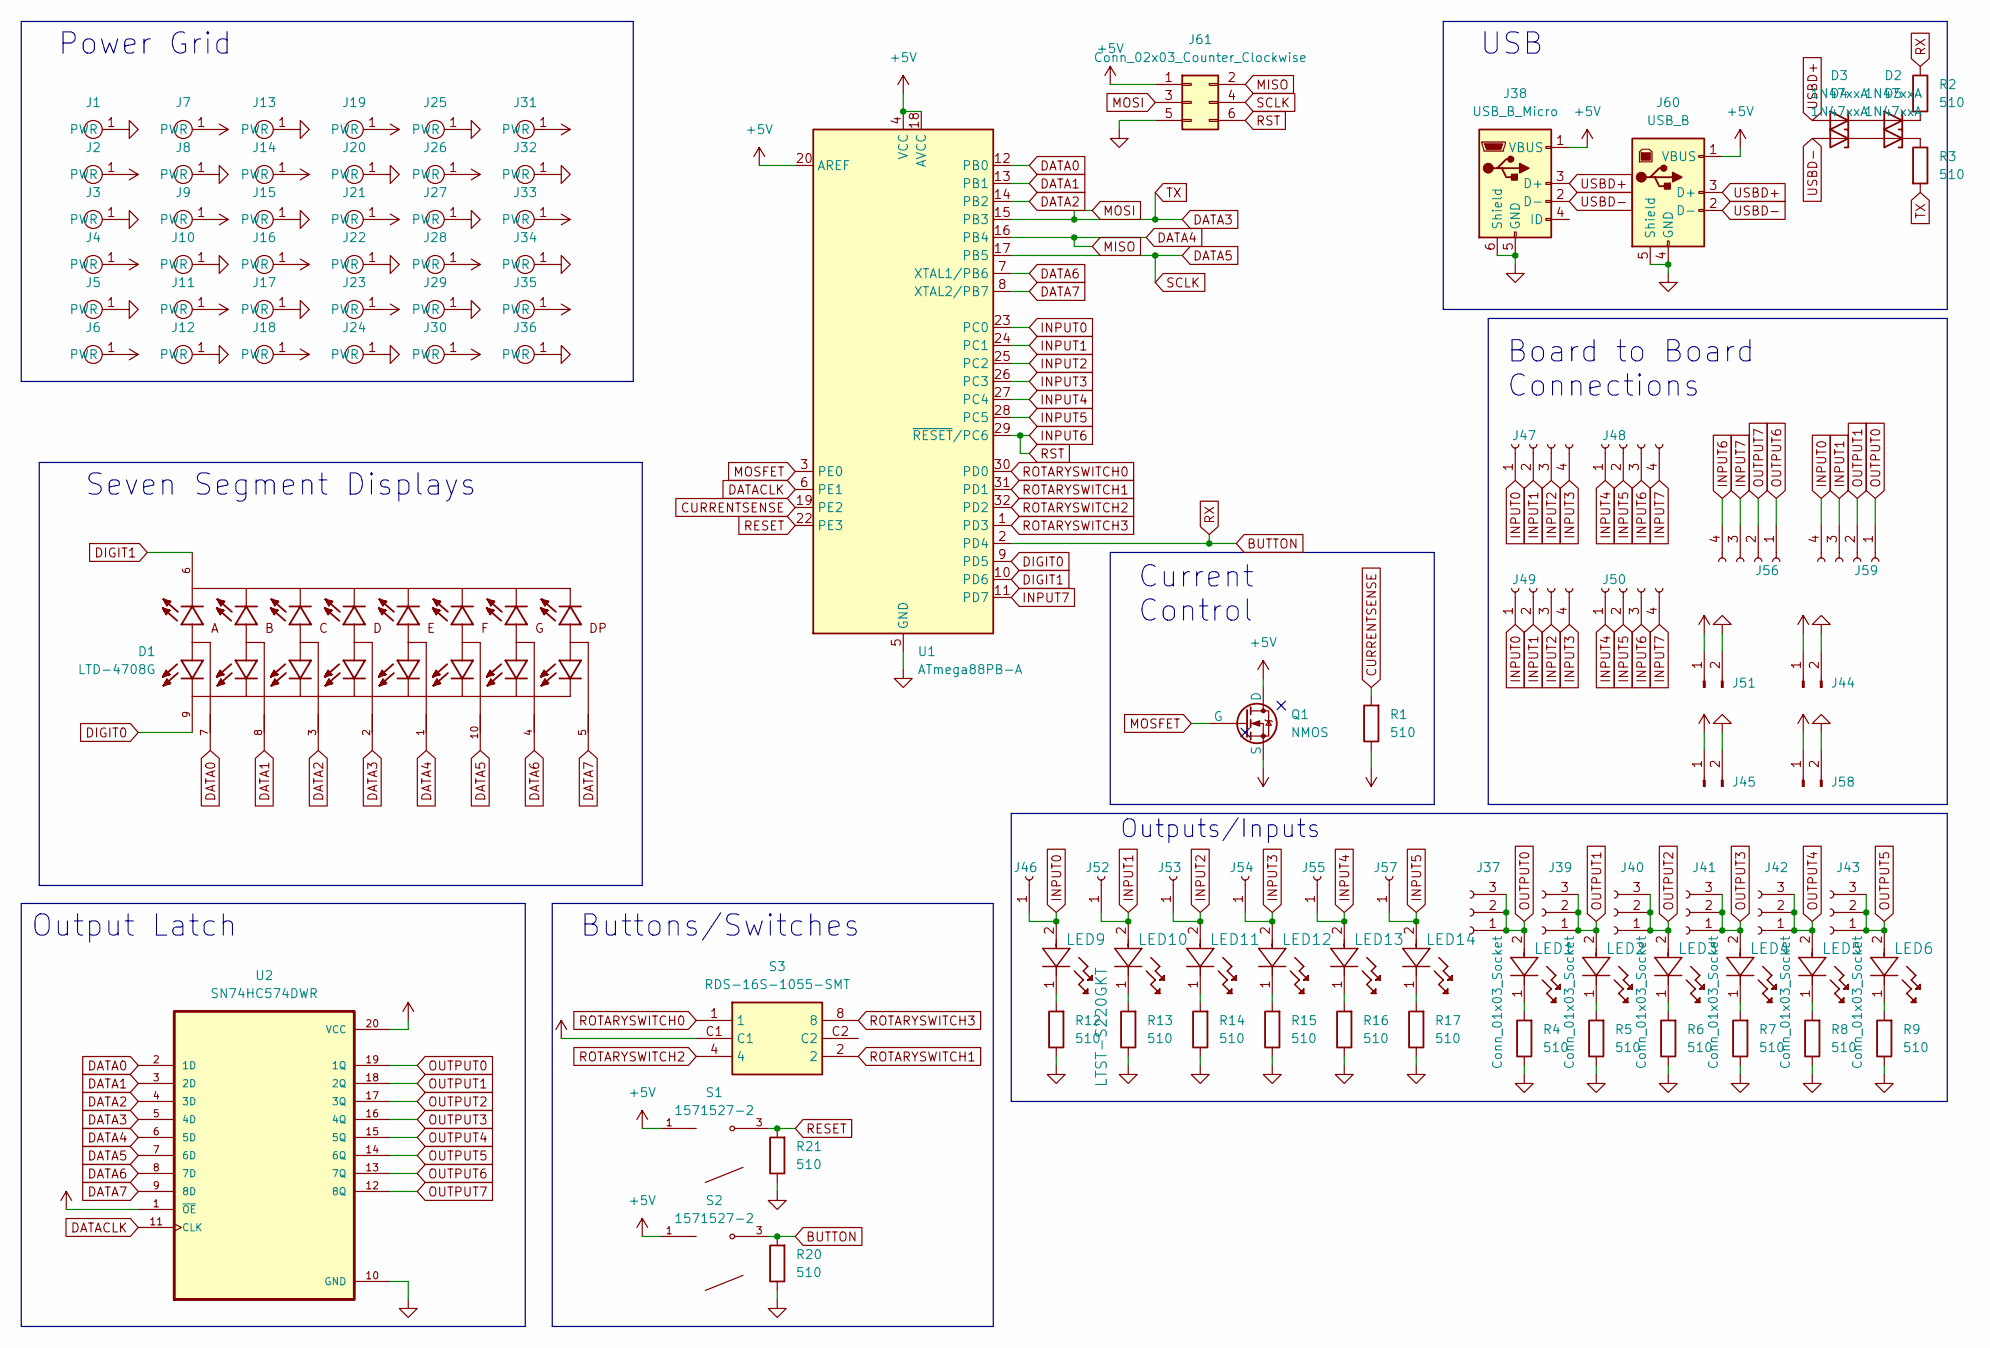
[picture p36: schematic BOARD.kicad_sch]

Parts:
D1: LTD-4708G; LED_LTD-4708G; PARTREV BNS-OD-C131/A4
D2, D3, D4, D5: 1N47xxA; D_DO-41_SOD81_P10.16mm_Horizontal
J1, J2, J3, J4, J5, J6, J7, J8, J9, J10, J11, J12, J13, J14, J15, J16, J17, J18, J19, J20, J21, J22, J23, J24, J25, J26, J27, J28, J29, J30, J31, J32, J33, J34, J35, J36: 8mm-snap
J37, J39, J40, J41, J42, J43: Conn_01x03_Socket; PinHeader_1x03_P2.54mm_Vertical
J38: USB_B_Micro; USB_Micro-B_Amphenol_10118194_Horizontal
J44, J45, J51, J58: Conn_01x02_Pin; PinHeader_1x02_P2.54mm_Horizontal
J46, J52, J53, J54, J55, J57: Conn_01x01_Socket; PinSocket_1x01_P2.54mm_Vertical
J47, J48, J49, J50, J56, J59: Conn_01x04_Socket; PinHeader_1x04_P2.54mm_Horizontal
J60: USB_B; USB_B_OST_USB-B1HSxx_Horizontal
J61: Conn_02x03_Counter_Clockwise; PinSocket_2x03_P2.54mm_Vertical
LED1, LED2, LED3, LED4, LED5, LED6, LED9, LED10, LED11, LED12, LED13, LED14: LTST-S220GKT; LED_LTST-S220GKT_LTO
Q1: NMOS; TO254P1041X444X1930-3
R1, R2, R3, R4, R5, R6, R7, R8, R9, R12, R13, R14, R15, R16, R17, R20, R21: 510; R_0805_2012Metric_Pad1.20x1.40mm_HandSolder
S1, S2: 1571527-2; SW_1571527-2; PARTREV V
S3: RDS-16S-1055-SMT; RDS16S1055SMT; Mouser Part Number 490-RDS-16S-1055-SMT
U1: ATmega88PB-A; TQFP-32_7x7mm_P0.8mm
U2: SN74HC574DWR; SOIC127P1030X265-20N

Connections:
+5V: J38.1 (VBUS), J60.1 (VBUS), J61.1, Q1.1 (D), S1.1, S2.1, U1.4 (VCC), U1.18 (AVCC), U1.20 (AREF)
BUTTON: R2.1, R20.2, S2.3, U1.2 (PD4)
CURRENTSENSE: R1.2, U1.19 (PE2)
DATA0: D1.7, U1.12 (PB0), U2.2 (1D)
DATA1: D1.8, U1.13 (PB1), U2.3 (2D)
DATA2: D1.3, U1.14 (PB2), U2.4 (3D)
DATA3: D1.2, J61.3, R3.2, U1.15 (PB3), U2.5 (4D)
DATA4: D1.1, J61.2, U1.16 (PB4), U2.6 (5D)
DATA5: D1.10, J61.4, U1.17 (PB5), U2.7 (6D)
DATA6: D1.4, U1.7 (XTAL1/PB6), U2.8 (7D)
DATA7: D1.5, U1.8 (XTAL2/PB7), U2.9 (8D)
DATACLK: U1.6 (PE1), U2.11 (CLK)
DIGIT0: D1.9, U1.9 (PD5)
DIGIT1: D1.6, U1.10 (PD6)
GND: J1.1 (PWR), J3.1 (PWR), J5.1 (PWR), J8.1 (PWR), J10.1 (PWR), J12.1 (PWR), J13.1 (PWR), J15.1 (PWR), J17.1 (PWR), J20.1 (PWR), J22.1 (PWR), J24.1 (PWR), J25.1 (PWR), J27.1 (PWR), J29.1 (PWR), J32.1 (PWR), J34.1 (PWR), J36.1 (PWR), J38.5 (GND), J38.6 (Shield), J44.2, J45.2, J51.2, J58.2, J60.4 (GND), J60.5 (Shield), J61.5, R4.1, R5.1, R6.1, R7.1, R8.1, R9.1, R12.1, R13.1, R14.1, R15.1, R16.1, R17.1, R20.1, R21.1, U1.5 (GND), U1.21 (GND), U2.10 (GND)
INPUT0: J46.1, J47.1, J49.1, J59.4, LED9.2, U1.23 (PC0)
INPUT1: J47.2, J49.2, J52.1, J59.3, LED10.2, U1.24 (PC1)
INPUT2: J47.3, J49.3, J53.1, LED11.2, U1.25 (PC2)
INPUT3: J47.4, J49.4, J54.1, LED12.2, U1.26 (PC3)
INPUT4: J48.1, J50.1, J55.1, LED13.2, U1.27 (PC4)
INPUT5: J48.2, J50.2, J57.1, LED14.2, U1.28 (PC5)
INPUT6: J48.3, J50.3, J56.4, J61.6, U1.29 (~RESET/PC6)
INPUT7: J48.4, J50.4, J56.3, U1.11 (PD7)
MOSFET: Q1.2 (G), U1.3 (PE0)
unnamed: D2.2 (A), D3.1 (K)
unnamed: D2.1 (K), R2.2
unnamed: D4.1 (K), D5.2 (A)
unnamed: D5.1 (K), R3.1
unnamed: LED1.1, R4.2
unnamed: LED2.1, R5.2
unnamed: LED3.1, R6.2
unnamed: LED4.1, R7.2
unnamed: LED5.1, R8.2
unnamed: LED6.1, R9.2
unnamed: LED9.1, R12.2
unnamed: LED10.1, R13.2
unnamed: LED11.1, R14.2
unnamed: LED12.1, R15.2
unnamed: LED13.1, R16.2
unnamed: LED14.1, R17.2
OUTPUT0: J37.1, J37.2, J37.3, J59.1, LED1.2, U2.19 (1Q)
OUTPUT1: J39.1, J39.2, J39.3, J59.2, LED2.2, U2.18 (2Q)
OUTPUT2: J40.1, J40.2, J40.3, LED3.2, U2.17 (3Q)
OUTPUT3: J41.1, J41.2, J41.3, LED4.2, U2.16 (4Q)
OUTPUT4: J42.1, J42.2, J42.3, LED5.2, U2.15 (5Q)
OUTPUT5: J43.1, J43.2, J43.3, LED6.2, U2.14 (6Q)
OUTPUT6: J56.1, U2.13 (7Q)
OUTPUT7: J56.2, U2.12 (8Q)
RESET: R21.2, S1.3, U1.22 (PE3)
ROTARYSWITCH0: S3.1, U1.30 (PD0)
ROTARYSWITCH1: S3.2, U1.31 (PD1)
ROTARYSWITCH2: S3.4, U1.32 (PD2)
ROTARYSWITCH3: S3.8, U1.1 (PD3)
USBD+: D3.2 (A), J38.3 (D+), J60.3 (D+)
USBD-: D4.2 (A), J38.2 (D-), J60.2 (D-)
VCC: J2.1 (PWR), J4.1 (PWR), J6.1 (PWR), J7.1 (PWR), J9.1 (PWR), J11.1 (PWR), J14.1 (PWR), J16.1 (PWR), J18.1 (PWR), J19.1 (PWR), J21.1 (PWR), J23.1 (PWR), J26.1 (PWR), J28.1 (PWR), J30.1 (PWR), J31.1 (PWR), J33.1 (PWR), J35.1 (PWR), J44.1, J45.1, J51.1, J58.1, Q1.3 (S), R1.1, S3.C1, U2.1 (~OE), U2.20 (VCC)

Notes on the sheet:
Seven Segment Displays
Board to Board Connections
Output Latch
USB
Buttons/Switches
Current Control
Outputs/Inputs
Power Grid

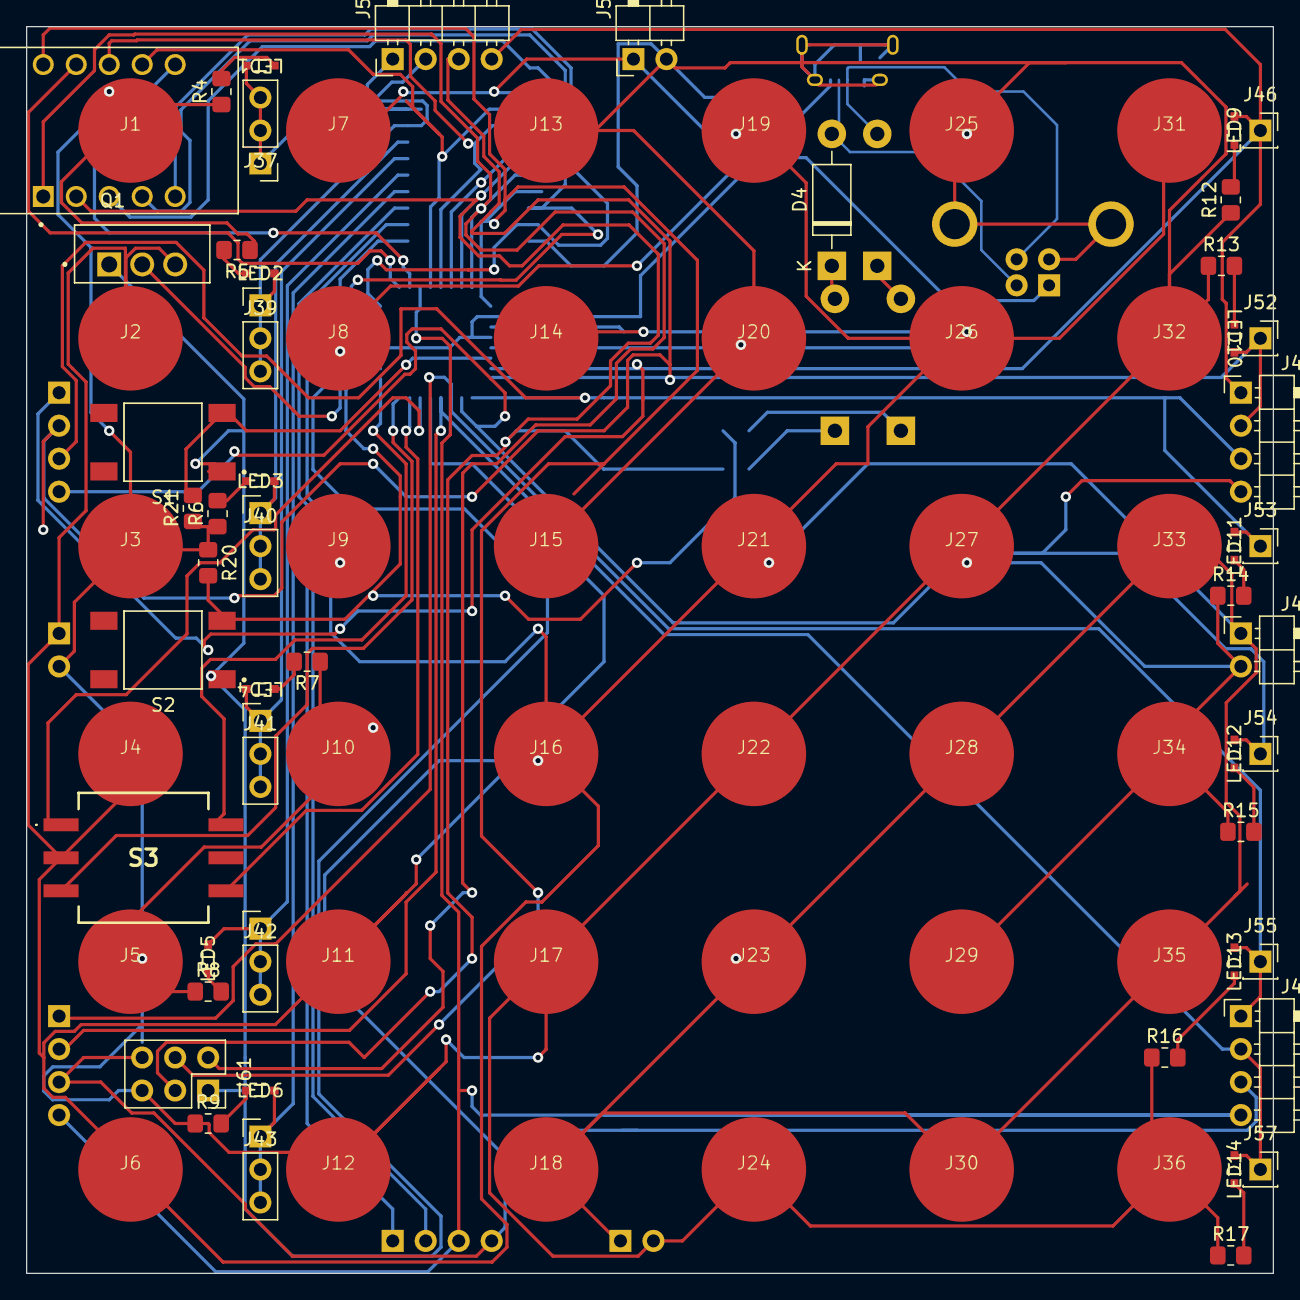
[picture p37: board BOARD.kicad_pcb from above]

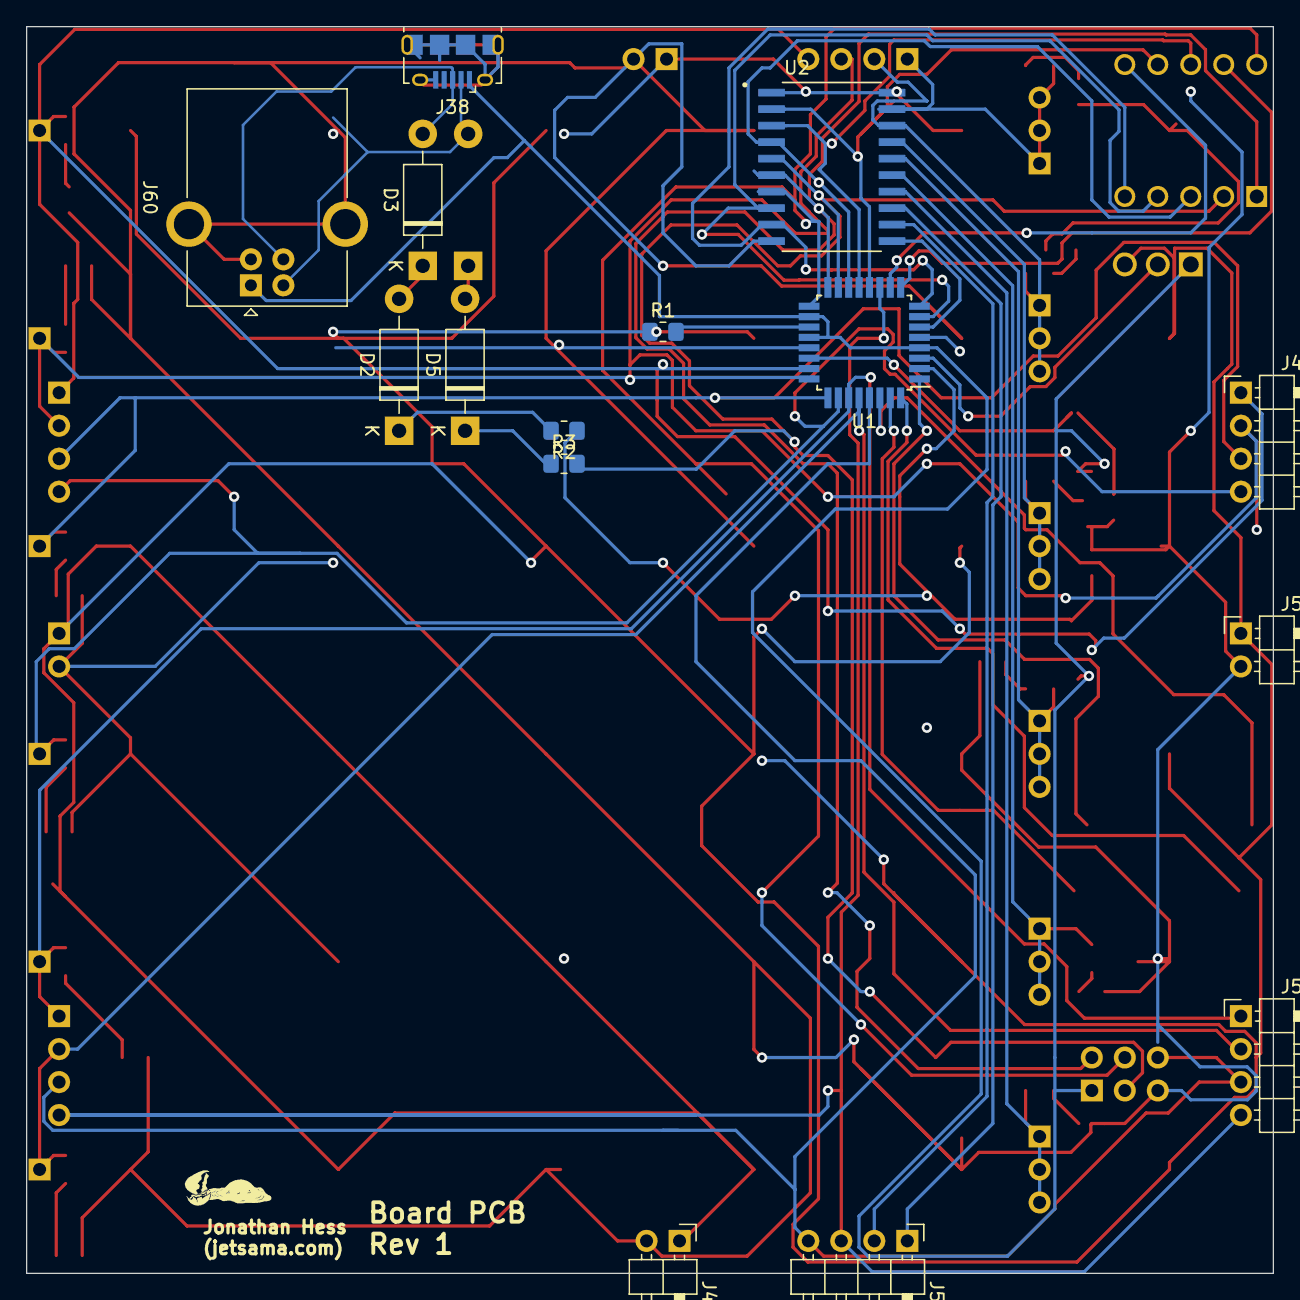
[picture p38: board BOARD.kicad_pcb from below]

Board: 2 copper layers, 96.0 x 96.0 mm, 101 parts (15 on the bottom side), 56 nets.
