Jetsama/DigitalLogicProject/PCBS/MUX/MUX.kicad_pcb

## KiCad design PCBS/MUX/MUX.kicad_pcb (2024-03-14)

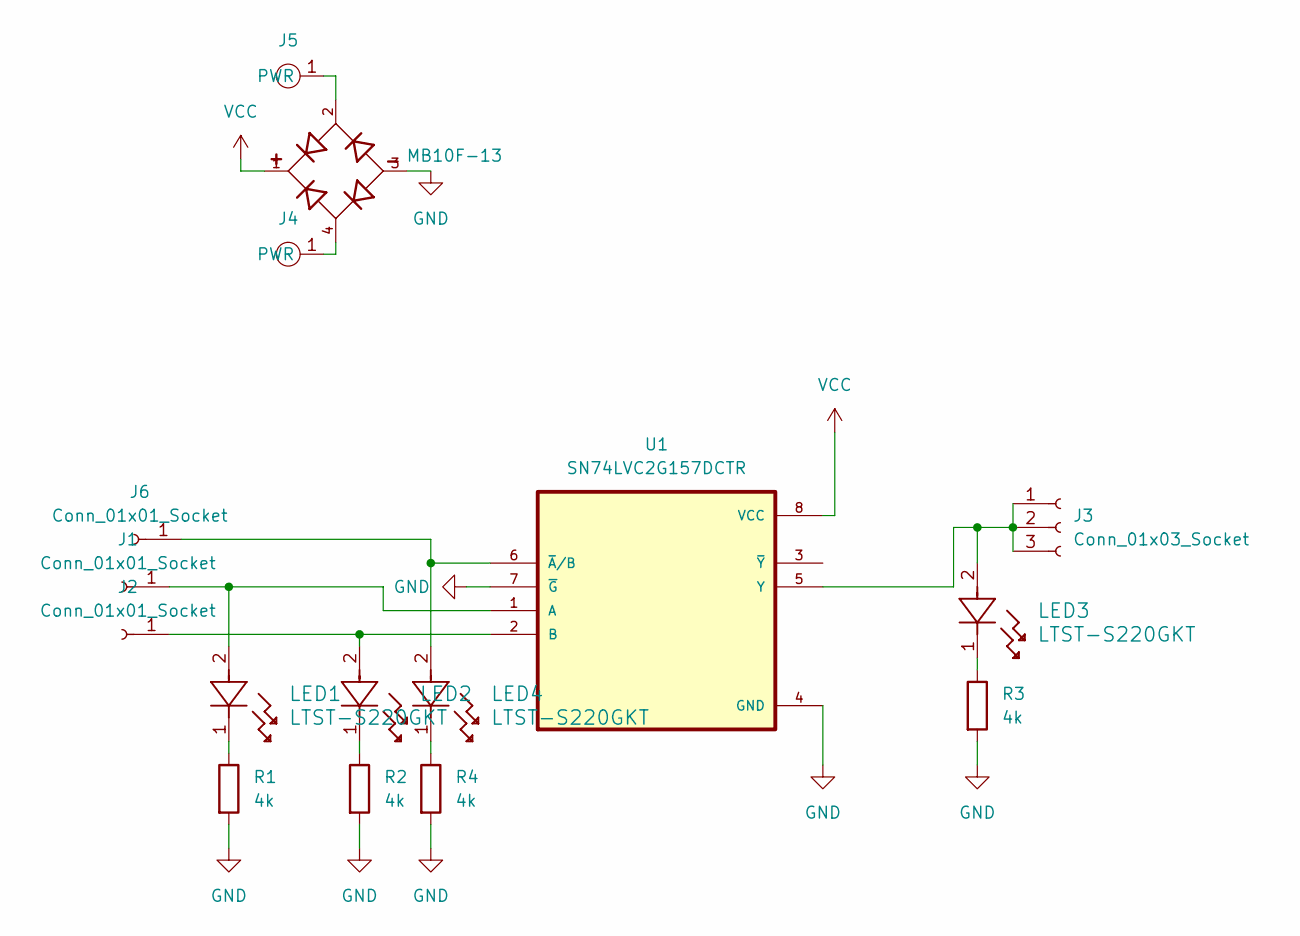
[picture p39: schematic MUX.kicad_sch]

Parts:
D1: MB10F-13; DIOB_MB10F-13; PARTREV 3 - 2
J1, J2, J6: Conn_01x01_Socket; PinSocket_1x01_P2.54mm_Vertical
J3: Conn_01x03_Socket; PinSocket_1x03_P2.54mm_Vertical
J4, J5: 8mm-snap
LED1, LED2, LED3, LED4: LTST-S220GKT; LED_LTST-S220GKT_LTO
R1, R2, R3, R4: 4k; R_0805_2012Metric_Pad1.20x1.40mm_HandSolder
U1: SN74LVC2G157DCTR; SOP65P400X130-8N

Connections:
GND: D1.3, R1.2, R2.2, R3.2, R4.2, U1.4 (GND), U1.7 (~G)
unnamed: J1.1, LED1.2, U1.1 (A)
unnamed: J2.1, LED2.2, U1.2 (B)
unnamed: J3.1, J3.2, J3.3, LED3.2, U1.5 (Y)
unnamed: D1.4, J4.1 (PWR)
unnamed: D1.2, J5.1 (PWR)
unnamed: J6.1, LED4.2, U1.6 (~A/B)
unnamed: LED1.1, R1.1
unnamed: LED2.1, R2.1
unnamed: LED3.1, R3.1
unnamed: LED4.1, R4.1
VCC: D1.1, U1.8 (VCC)

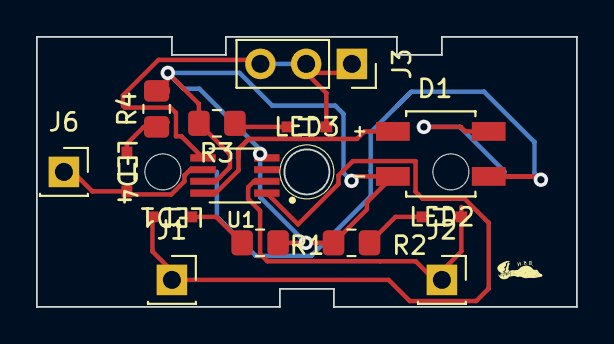
[picture p40: board MUX.kicad_pcb from above]

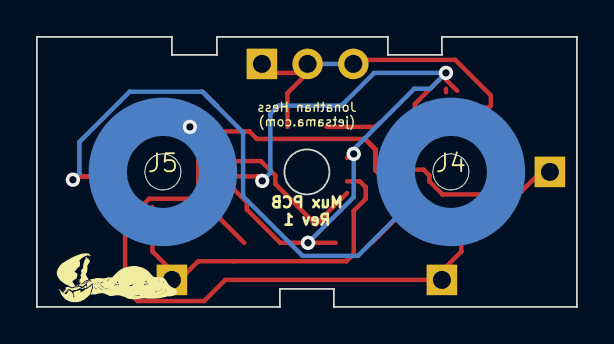
[picture p41: board MUX.kicad_pcb from below]

Board: 2 copper layers, 30.0 x 15.0 mm, 16 parts (2 on the bottom side), 12 nets.
