Jetsama/DigitalLogicProject/PCBS/SWITCHES/SWITCHES.kicad_pcb

## KiCad design PCBS/SWITCHES/SWITCHES.kicad_pcb (2024-03-14)

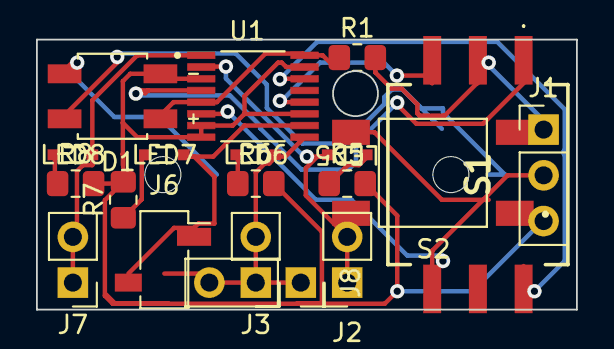
[picture p42: board SWITCHES.kicad_pcb from above]

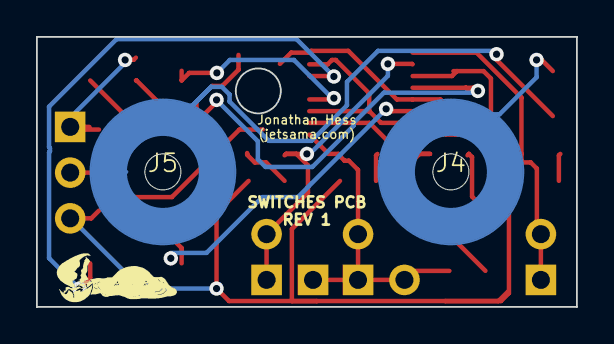
[picture p43: board SWITCHES.kicad_pcb from below]

Board: 2 copper layers, 30.0 x 15.0 mm, 21 parts (2 on the bottom side), 17 nets.

Parts:
D1: locked; DIOB_MB10F-13
J1: Conn_01x03_Pin; PinHeader_1x03_P2.54mm_Vertical
J2: Conn_01x02_Socket; PinSocket_1x02_P2.54mm_Vertical
J3, J7: Conn_01x02_Socket; PinHeader_1x02_P2.54mm_Vertical
J4, J5: 8mm-snap
J6: Conn_01x02_Socket; PinSocket_1x02_P2.54mm_Vertical_SMD_Pin1Right
J8: Conn_01x03_Socket; PinSocket_1x03_P2.54mm_Vertical
LED5, LED6, LED7, LED8: LTST-S220GKT; LED_LTST-S220GKT_LTO
R1: 10k; R_0805_2012Metric_Pad1.20x1.40mm_HandSolder
R5, R6, R7, R8: 4k; R_0805_2012Metric_Pad1.20x1.40mm_HandSolder
S1: RDS-16S-1055-SMT; RDS16S1055SMT
S2: 1571527-2; SW_1571527-2
U1: CD4043BPWR; SOP65P640X120-16N

Connections:
/DEBOUNCE0: S1.1, U1.4 (S1)
/DEBOUNCE1: J1.2, S1.2, S2.4, U1.6 (S2)
/DEBOUNCE2: S1.4, U1.12 (S3)
/DEBOUNCE3: S1.8, U1.14 (S4)
/OUTPUT0: J2.1, J2.2, LED5.2, S2.2, U1.2 (Q1)
/OUTPUT1: J3.1, J3.2, J8.1, J8.3, LED6.2, U1.9 (Q2)
/OUTPUT2: J6.1, J6.2, LED7.2, U1.10 (Q3)
/OUTPUT3: J7.1, J7.2, LED8.2, U1.1 (Q4)
/VCC_RES: J1.1, R1.2, S1.C1, S2.3
GND: D1.3, J1.3, R5.2, R6.2, R7.2, R8.2, S2.1, U1.3 (R1), U1.7 (R2), U1.8 (VSS), U1.11 (R3), U1.15 (R4)
unnamed: D1.4, J4.1 (PWR)
unnamed: D1.2, J5.1 (PWR)
unnamed: LED5.1, R5.1
unnamed: LED6.1, R6.1
unnamed: LED7.1, R7.1
unnamed: LED8.1, R8.1
VCC: D1.1, R1.1, U1.5 (ENABLE), U1.16 (VDD)
