Jetsama/DigitalLogicProject/(commit log)

2023-12-24 And gate start
    [ANDGATE.kicad_pcb, ANDGATE.kicad_sch]
2023-12-26 header pins and pcb start
    [ANDGATE.kicad_pcb, ANDGATE.kicad_sch]
2023-12-28 AND GATE passes DRC but with silk screen warnings
    [ANDGATE.kicad_pcb, ANDGATE.kicad_sch, bom.csv, designators.csv, positions.csv]
2023-12-28 Added mounting holes
    [ANDGATE.kicad_pcb]
2023-12-28 Added HBB logo
    [ANDGATE.kicad_pcb]
2023-12-29 Changed pins to 2.54mm from 1mm
    [ANDGATE.kicad_pcb, ANDGATE.kicad_sch]
2024-01-23 AND Gate Inventor 3D casing
    [ANDGATE PCB.0001.ipt, ANDGATE PCB.ipt, ANDGATE.0008.ipt, ANDGATE.iam, ANDGATE.ipt, ANDGATE.kicad_pcb, ANDGATE.step, ANDGATEASSEMBLY.iam]
2024-01-30 NOT gate PCB
    [ANDGATE PCB.0001.ipt, ANDGATE PCB.ipt, ANDGATE.0008.ipt, ANDGATEASSEMBLY.iam, NOTGATE.iam, NOTGATE.ipt, NOTGATE.kicad_pcb, NOTGATE.kicad_sch]
2024-02-12 Added Mux PCB
    [ANDGATE PCB.0001.ipt, ANDGATE PCB.ipt, ANDGATE.0008.ipt, ANDGATEASSEMBLY.iam, GATE.iam, GATE.ipt, GATE.kicad_pcb, GATE.kicad_sch]
2024-02-13 Input PCB Start
    [ANDGATE PCB.0001.ipt, ANDGATE PCB.ipt, ANDGATE.0008.ipt, ANDGATEASSEMBLY.iam, PinSocket_1x01_P2.54mm_Vertical.iam, PinSocket_1x03_P2.54mm_Vertical.iam, Quarter.ipt, R_0805_2012Metric.iam]
2024-02-13 Input PCB layout start
    4 Rocker Switches will not fit in 1x2 grid size but rotary switch might
    [SWITCHES.kicad_pcb, SWITCHES.kicad_sch]
2024-02-14 DRC pass on Inputs
    Need to find way to flip headers and add space inbetween headers. That or create way of shorting socket connections without PCB.
    [SWITCHES.kicad_pcb]
2024-02-14 Added Screw Hole
    [SWITCHES.kicad_pcb]
2024-02-14 move Logo
    [SWITCHES.kicad_pcb]
2024-02-14 Completed. SilkScreen changes necessary
    Uses one SMD right pin header socket for the rotary switch
    [SWITCHES.kicad_pcb, SWITCHES.kicad_sch]
2024-02-16 Finished input PCB and fixed mux and not
    [ANDGATE-B_Cu.gbr, ANDGATE-B_Mask.gbr, ANDGATE-B_Paste.gbr, ANDGATE-B_Silkscreen.gbr, ANDGATE-Edge_Cuts.gbr, ANDGATE-F_Cu.gbr, ANDGATE-F_Mask.gbr, ANDGATE-F_Paste.gbr]
2024-02-16 Fixed mux
    [MUX.kicad_pcb]
2024-02-16 Adding 3D models
    [1571527-2.step, CD4043BPWR.step, CUI_DEVICES_RDS-16S-1045-D.step, CUI_DEVICES_RDS-16S-1055-SMT.step, MB10F-13.step, MUX.kicad_pcb, NOTGATE.kicad_pcb, SN74LVC1G08DBVRE4.step]
2024-02-17 Created LICENSE for non commercial use
    With the goal to allow schools or individuals to create free of charge but remove commercial use.
2024-02-19 Added Board PCB
    [ANDGATE PCB.0001.ipt, ANDGATE PCB.ipt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]
2024-03-07 Gate Rev 2 and Board Updates
    [ANDGATE PCB.0001.ipt, ANDGATE PCB.0003.ipt, ANDGATE PCB.ipt, ANDGATE.0001.iam, ANDGATE.0009.ipt, ANDGATE.iam, ANDGATE.ipt, ANDGATE.step]
2024-03-07 Honors poster
    [SWITCHES.kicad_sch]
2024-03-14 Rev1 board/mux/switches/output
    [ANDGATE PCB.0001.ipt, ANDGATE.0008.ipt, ANDGATE.step, ANDGATEASSEMBLY.iam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]
2024-03-15 Not Gate and And Gate models
    [ANDGATE.0009.ipt, ANDGATE.0010.ipt, ANDGATE.ipt, LightPipe.0001.ipt, LightPipe.ipt, NOTGATE.0003.ipt, NOTGATE.ipt, NOTGATE2.0003.ipt]
2024-03-15 Gate Casings
    [ANDGATE.0010.ipt, ANDGATE.0013.ipt, ANDGATE.ipt, ANDGATEASSEMBLY.0002.iam, ANDGATEASSEMBLY.iam, GATE PCB.0002.ipt, GATE PCB.0003.ipt, GATE PCB.ipt]
2024-03-15 Mux Casing
    [LightPipe.0001.ipt, LightPipe.0002.ipt, LightPipe.ipt, LightPipeThin.ipt, MUX.0008.ipt, MUX.ipt, MUX.step, MUXAssembly1.iam]
2024-03-28 Updated gates models to 2mm hole
    [ANDGATE.0013.ipt, ANDGATE.0015.ipt, ANDGATE.ipt, ANDGATE.stl, LightPipe.0002.ipt, LightPipe.0003.ipt, LightPipe.ipt, LightPipe.stl]
2024-04-11 Update screw hole and start board code
    [MUX.0008.ipt, MUX.0009.ipt, MUX.ipt, MUX.stl]
2024-05-09 Images and Poster
    [ANDGATEASSEMBLY.0002.iam, ANDGATEASSEMBLY.0003.iam, ANDGATEASSEMBLY.iam, GATE PCB.0003.ipt, GATE PCB.0004.ipt, GATE PCB.ipt, MUX.0009.ipt, MUX.0010.ipt]
